swholmstead/Excavator/pictures/Excavator.jpeg

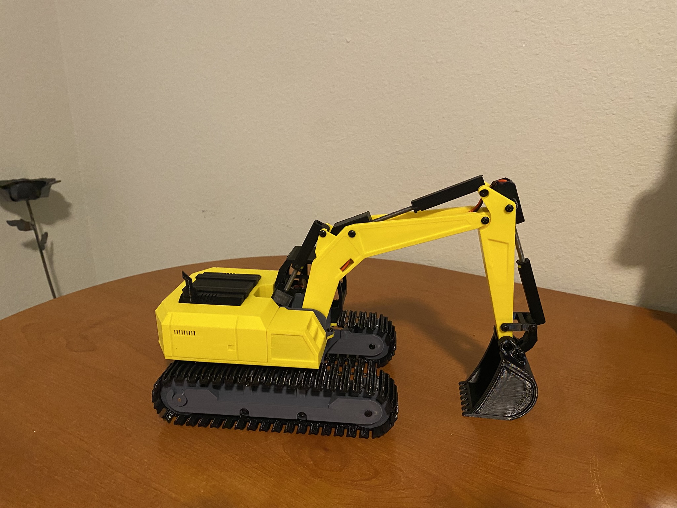
pictures/Excavator.jpeg
