swholmstead/Excavator/docs/bom.md

<h2>Bill of Materials</h2>

All of these components are common and can be found online. I have provided links to Amazon and AliExpress, but these vendors may change over time. If the links don't work, just search for the components from wherever you shop.

* ESP32 WROOM-32 Development Board [Amazon](https://www.amazon.com/dp/B08D5ZD528) [AliExpress](https://www.aliexpress.us/item/3256805767190776.html)
    * This is available with micro USB or USB-C.  Get the one that you like.
* N20 12V 100 RPM motors (qty 4) [Amazon](https://www.amazon.com/gp/product/B0B8DB6NC8) [AliExpress](https://www.aliexpress.us/item/3256806632632389.html)
* N20 12V 1000 RPM 55 mm motors (qty 3) [Amazon](https://www.amazon.com/dp/B0DGSZRN4X) [AliExpress](https://www.aliexpress.us/item/3256808399549453.html)
* M4 hex nut (qty 3) [Amazon](https://www.amazon.com/dp/B0CMC61C9D) [AliExpress](https://www.aliexpress.us/item/3256807407546447.html)
* 12.5 mm Micro Slip Ring 4 channel (qty 1) [Amazon](https://www.amazon.com/dp/B0D9L8DL1L) [AliExpress](https://www.aliexpress.us/item/3256805848469478.html)
    * You can always buy a slip ring with more channels and just cut off the extra wires.
* 5V Buck Converter [Amazon](https://www.amazon.com/dp/B0DGPZ91BD) [AliExpress](https://www.aliexpress.us/item/3256807692095306.html)
* DRV8833 H-bridge (qty 4) [Amazon](https://www.amazon.com/dp/B0DB8CX8LK) [AliExpress](https://www.aliexpress.us/item/3256806096142480.html)
* JST-XH connectors with 20 cm of wire (qty 8) [Amazon](https://www.amazon.com/dp/B0FHQ4F2Z2) [AliExpress](https://www.aliexpress.us/item/2251832479273592.html)
* SS12D10 SPDT micro slide switch [Amazon](https://www.amazon.com/gp/product/B09R41P1JF) [AliExpress](https://www.aliexpress.us/item/2255800493933955.html)
* PCB Headers 2.54 mm pitch [Amazon](https://www.amazon.com/2-54MM-Breakaway-Connector-Arduino-Prototype/dp/B08DVGCTKT) [AliExpress](https://www.aliexpress.us/item/2255800687544049.html)
* BLX-A Fuse holder 5 mm x 20 mm  (qty 1) [Amazon](https://www.amazon.com/dp/B093FK3GB1) [AliExpress](https://www.aliexpress.us/item/3256808172588255.html)
* 5A Fast-blow fuse 5 mm x 20 mm  (qty 1) [Amazon](https://www.amazon.com/dp/B07V5MYBL1) [AliExpress](https://www.aliexpress.us/item/3256803802728124.html)
* CR123a battery holder (qty 2) [Amazon](https://www.amazon.com/gp/product/B08RD1KQN3) [AliExpress](https://www.aliexpress.us/item/3256806203437629.html)
* CR123a rechargeable batteries (qty 2)
    * You can buy the batteries plus a charger [Amazon](https://www.amazon.com/dp/B0CF1SXDZ1)
    * Or get the ones with a built in charger [Amazon](https://www.amazon.com/dp/B0D3H7PBK8)
* 3 mm 12V LED lights [Amazon](https://www.amazon.com/dp/B07T9KX9BP) [AliExpress](https://www.aliexpress.us/item/3256803264288460.html)
* 3 mm LED holder [Amazon](https://www.amazon.com/dp/B07NRWLWCP) [AliExpress](https://www.aliexpress.us/item/3256803821521152.html)
* M2.6 x 6 mm self-tapping pan head screws [Amazon](https://www.amazon.com/dp/B08QF455PJ) [AliExpress](https://www.aliexpress.us/item/3256806345826640.html)
* M2.6 x 8 mm self-tapping pan head screws [Amazon](https://www.amazon.com/dp/B08QF455PJ) [AliExpress](https://www.aliexpress.us/item/3256806345826640.html)

<h3>Claw Parts</h3>
You only need these parts if using the claw option.  Not required for bucket.

* 6 mm or 6.5 mm Micro Slip Ring 4 channel (qty 1) [Amazon](https://www.amazon.com/dp/B07YKYDFCH) [AliExpress](https://www.aliexpress.us/item/3256807273542039.html)
    * Print part 34 and 38 for the correct size of slip ring that you buy.
    * You can always buy a slip ring with more channels and just cut off the extra wires.
* 21g Mini Metal Servo (qty 1) - these are more powerful than standard 9g servos [Amazon](https://www.amazon.com/dp/B0D5QJVRC1) [AliExpress](https://www.aliexpress.us/item/3256804867324754.html)

<h3>Optional</h3>

* JST-XH Crimp Connectors [Amazon](https://www.amazon.com/dp/B0B2R966ZY) [AliExpress](https://www.aliexpress.us/item/3256806894018733.html)
* Clear Heat Shrink Tubing [Amazon](https://www.amazon.com/dp/B01M6YB9CB) [AliExpress](https://www.aliexpress.us/item/3256805092198563.html)
    * I like to label my wires with a label maker and cover it with clear heat shrink tubing.
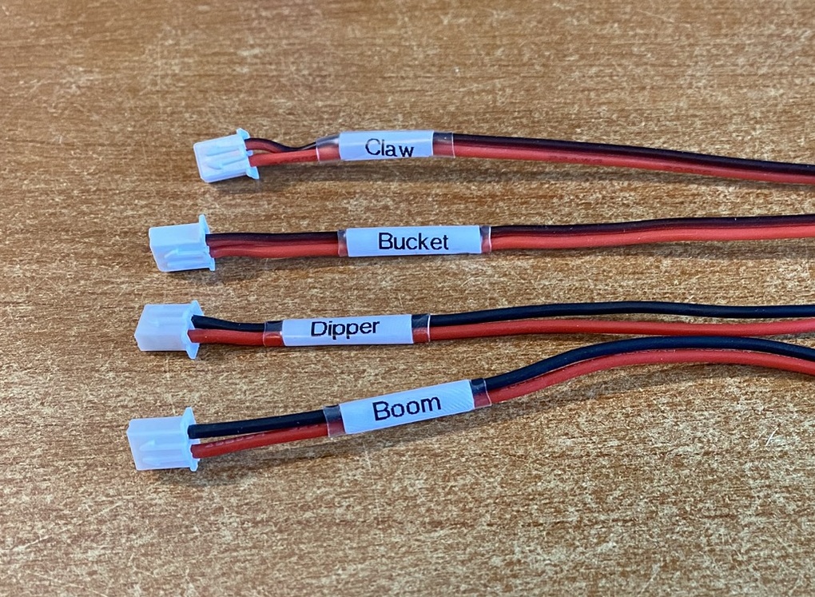
[picture p12: pictures/Heat_Shrink.jpg]
Wire Labels
