swholmstead/Excavator/docs/assembly.md

<h2>Assembly Instructions</h2>

<h3>Lower Body</h3>

Push N20 100 rpm motors into Wheel Motors.

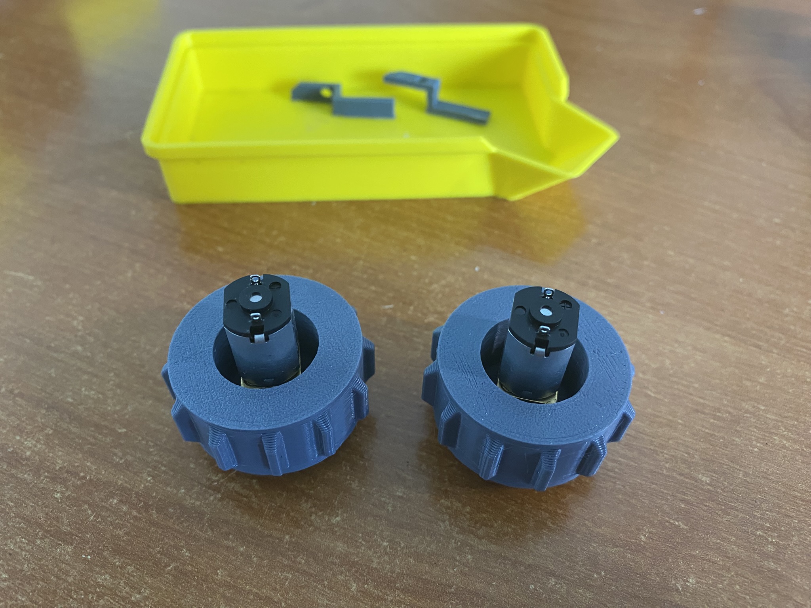
[picture p13: pictures/IMG_3700.JPEG]
Wheel Motor


Insert Wheel Motor assembly into Track Support Left. Secure with Motor Lock Left and a M2.6 x 6 mm screw.  I like to make sure
positive (+) terminal on the motor is on top.  It makes it easier for soldering later.

Insert Wheel Idler on other end of Track Support Left and secure with M2.6 x 8 mm screws.  Make sure screws are loose enough
for idler wheel to rotate freely.

Insert 2 Track Roller Uppers and 2 Track Roller Lowers onto Track Support Left and secure with M2.6 x 6 mm screws.  Make sure
that all rollers can rotate freely.

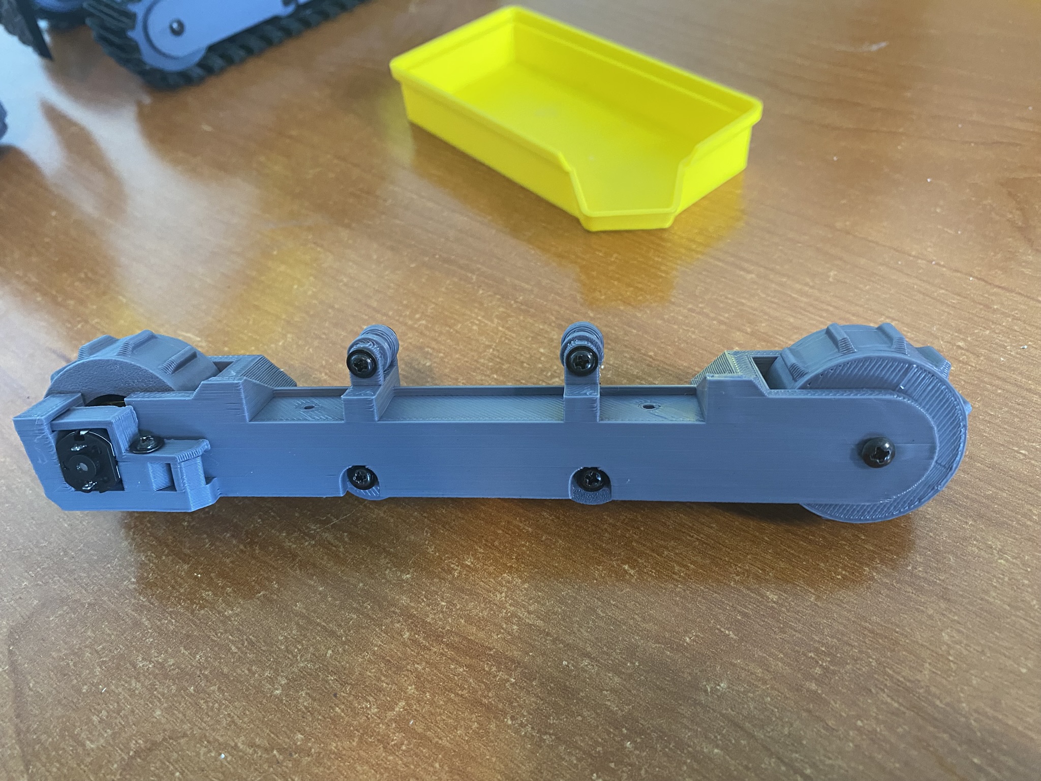
[picture p14: pictures/IMG_3701.JPEG]


Repeat same steps for Track Support Right.

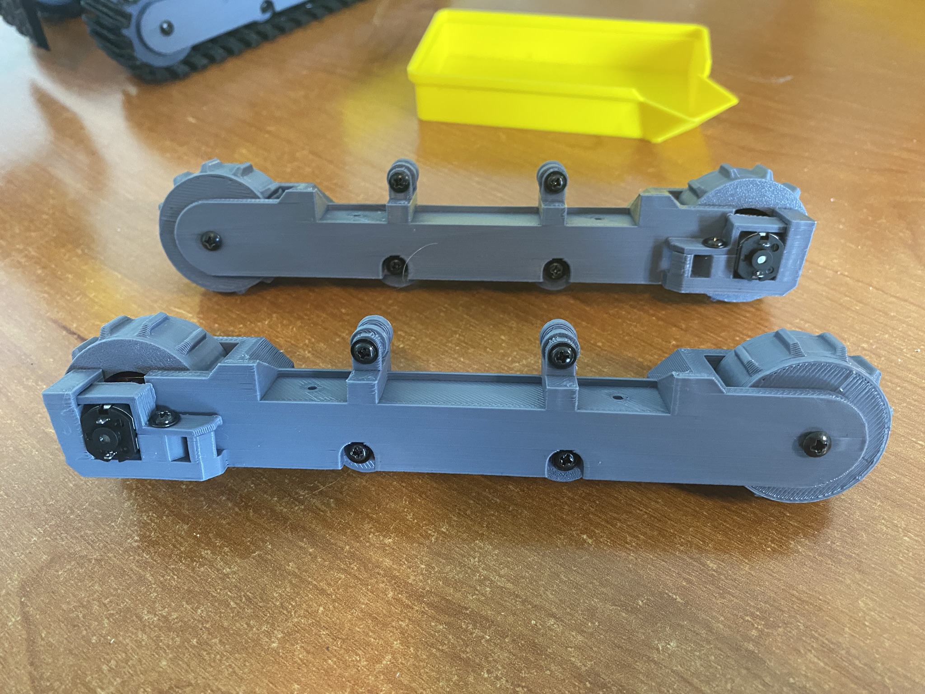
[picture p15: pictures/IMG_3703.JPEG]


Attach Lower Frame between left and right track supports and secure with M2.6 x 8 mm screws.  Ensure that the wire channel faces towards
the rear with the N20 100 rpm motors.

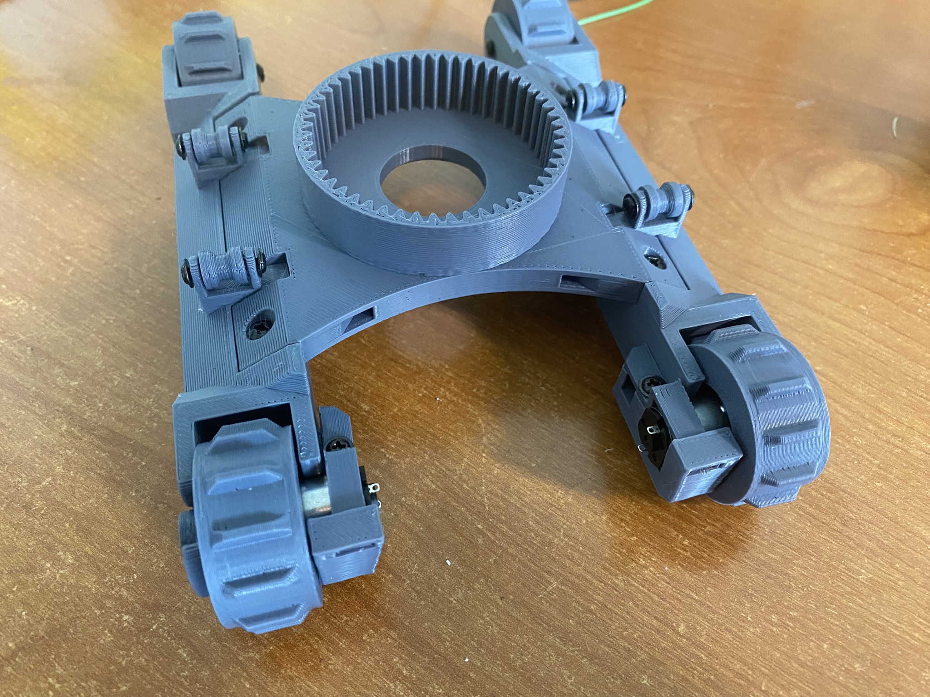
[picture p16: pictures/IMG_3704.JPEG]
Lower Frame


Insert the 12.5 mm slip ring into the Slip Ring Lock.  

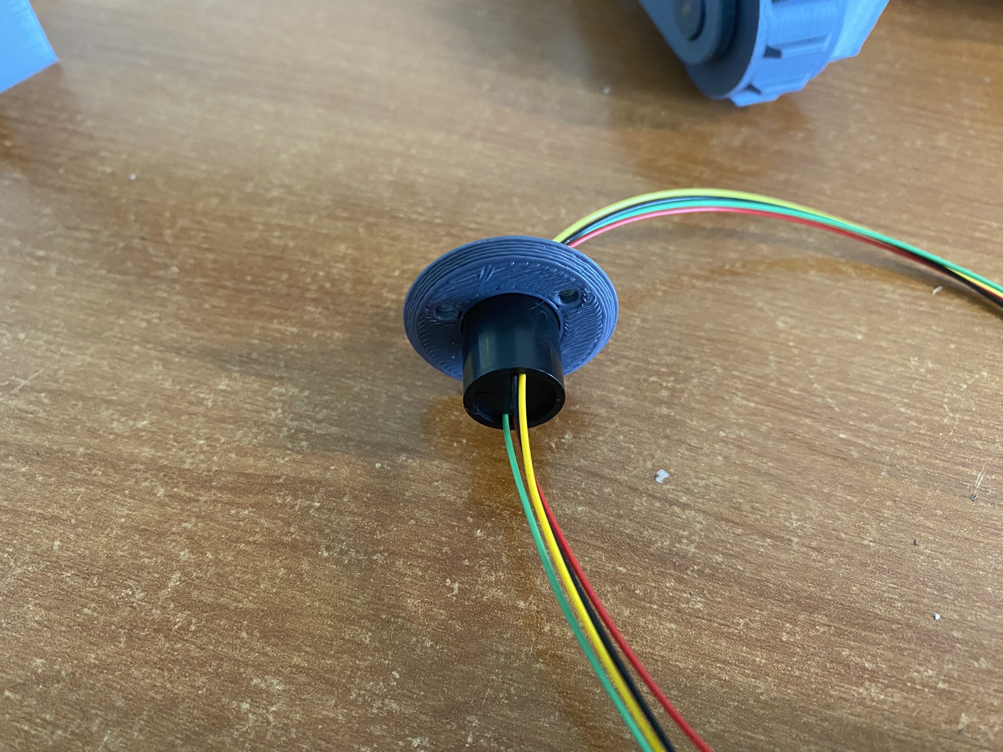
[picture p17: pictures/IMG_3705.JPEG]


Assemble the Track Support and Lower Body.  Push the wires of the slip ring through from the bottom and secure the
slip ring with M2.6 x 8 mm screws. Make sure the lower cab can freely rotate from the track support assembly.

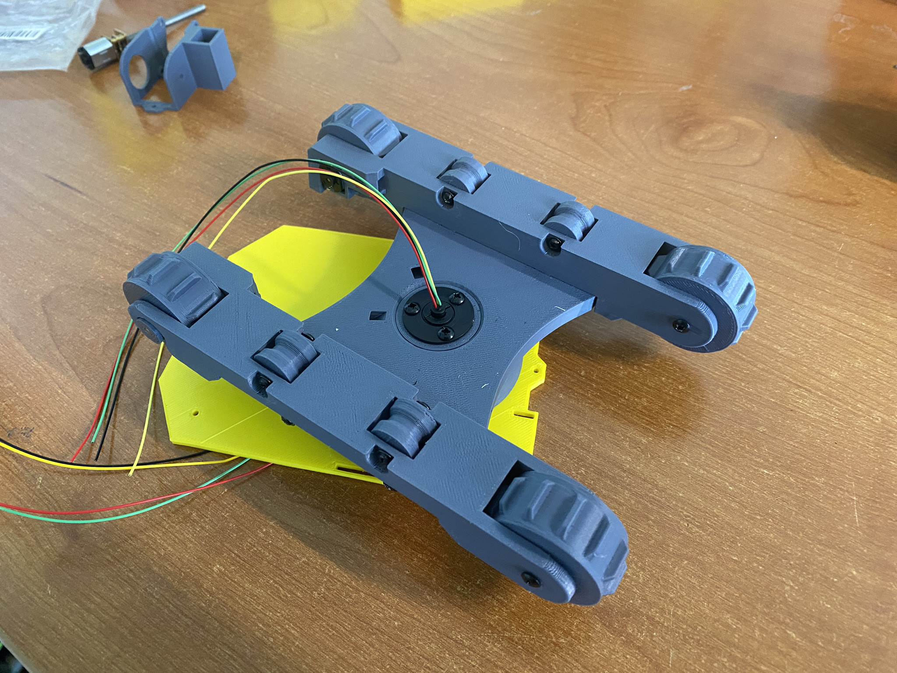
[picture p18: pictures/IMG_3706.JPEG]

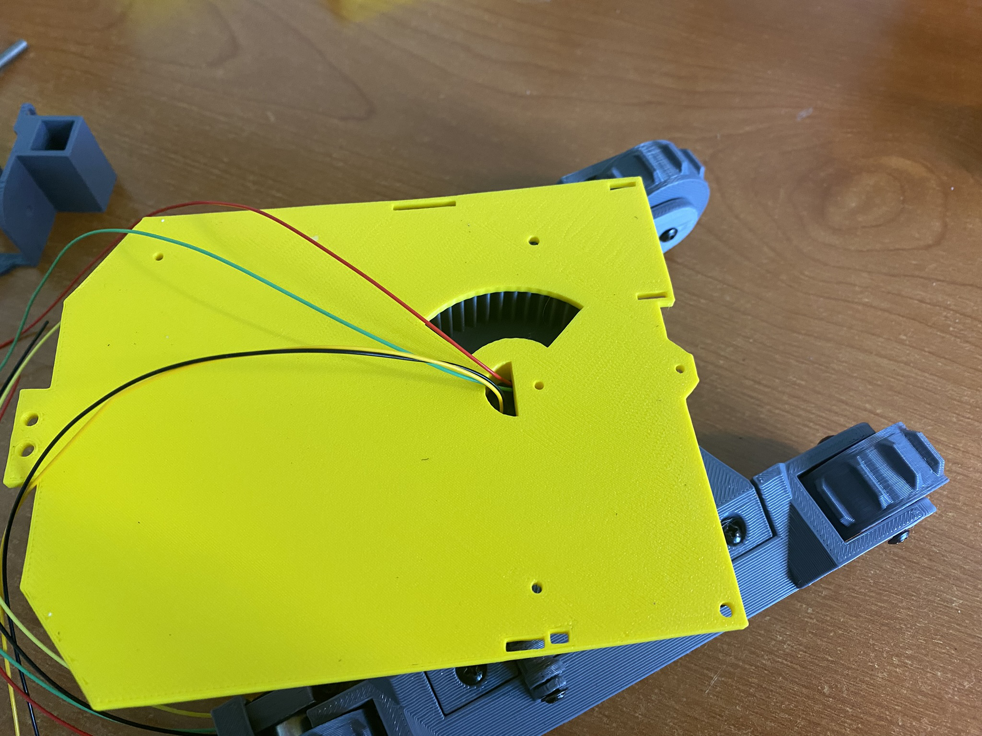
[picture p19: pictures/IMG_3707.JPEG]


Route a pair of wires to each motor.  Cut to length and solder wires to motors.

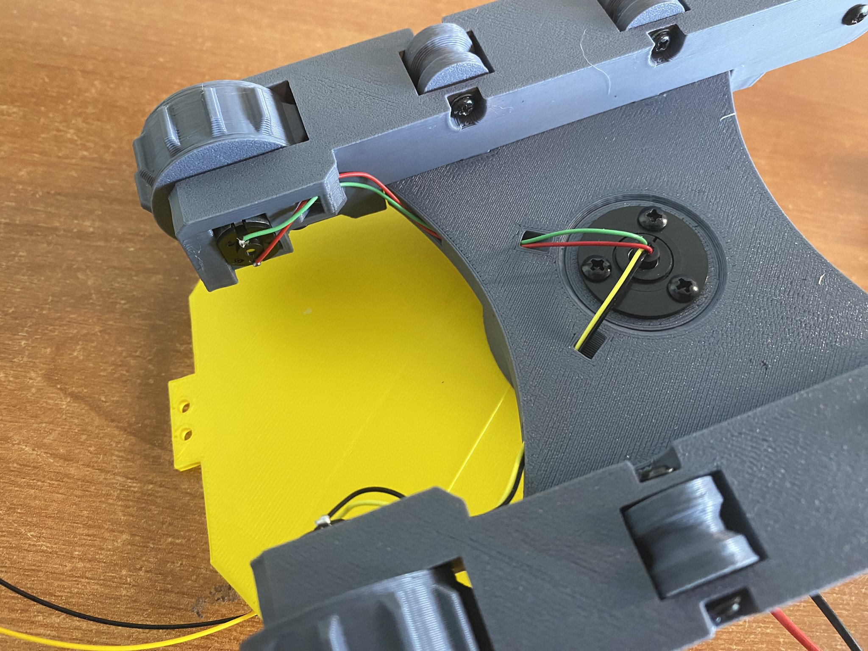
[picture p20: pictures/IMG_3712.JPEG]


Push N20 100 rpm motor into Main Boom Holder and press Pinion Gear on other side.

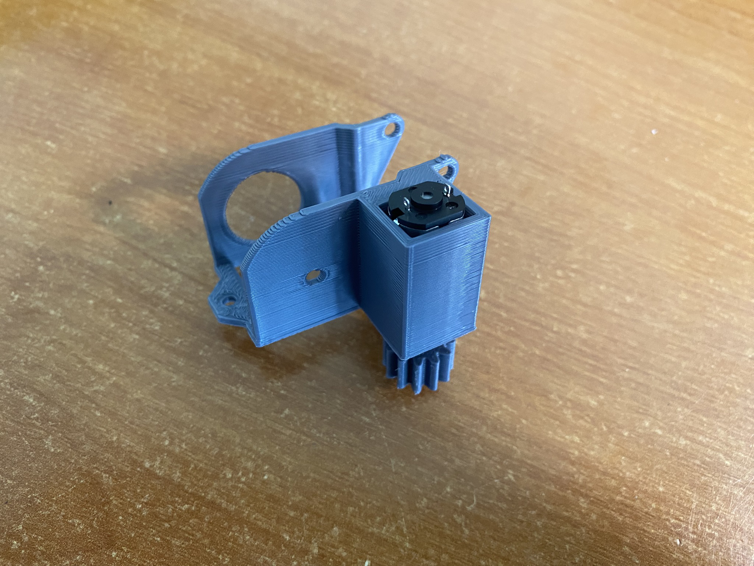
[picture p21: pictures/IMG_3709.JPEG]


Attach Main Boom Holder to base with M2.6 x 8 mm screws.  Attach JST-XH connector to 8 cm of wire and solder to
swing motor.

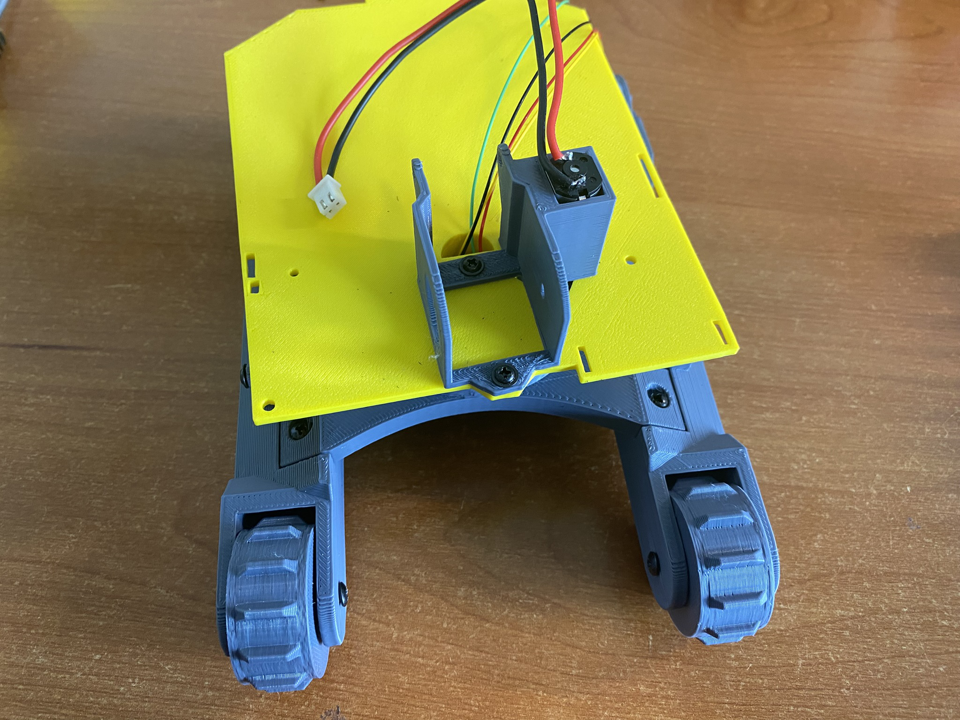
[picture p22: pictures/IMG_3713.JPEG]


Attach circuit board to lower body with M2.6 x 6 mm screws.  Add JST-XH connectors for left/right track motors
from swivel ring and attach to circuit board.  Attach swivel motor to circuit board. 

Attach seat to lower body with M2.6 x 6 mm screw.

Install TPU tracks.

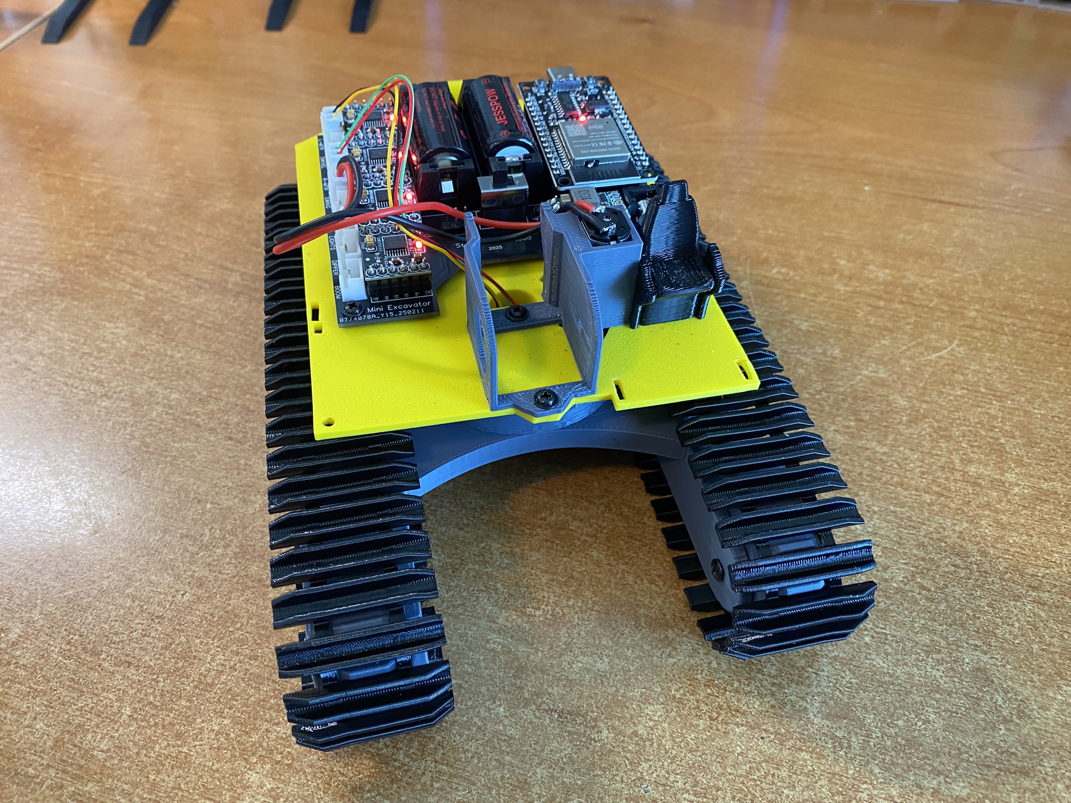
[picture p23: pictures/IMG_3728.JPEG]
Lower Body


You should be able to power on, connect XBox/PS controller, and verify operation of tracks and swivel.
Remember, to operate tracks, you must be in drive mode.  To switch out of drive mode, press in on the left joystick.
Then you will be able to operate swivel (and boom when finally connected).

<h3>Boom and Dipper Arms</h3>

Attach boom to dipper with M2.6 x 6 mm screws.

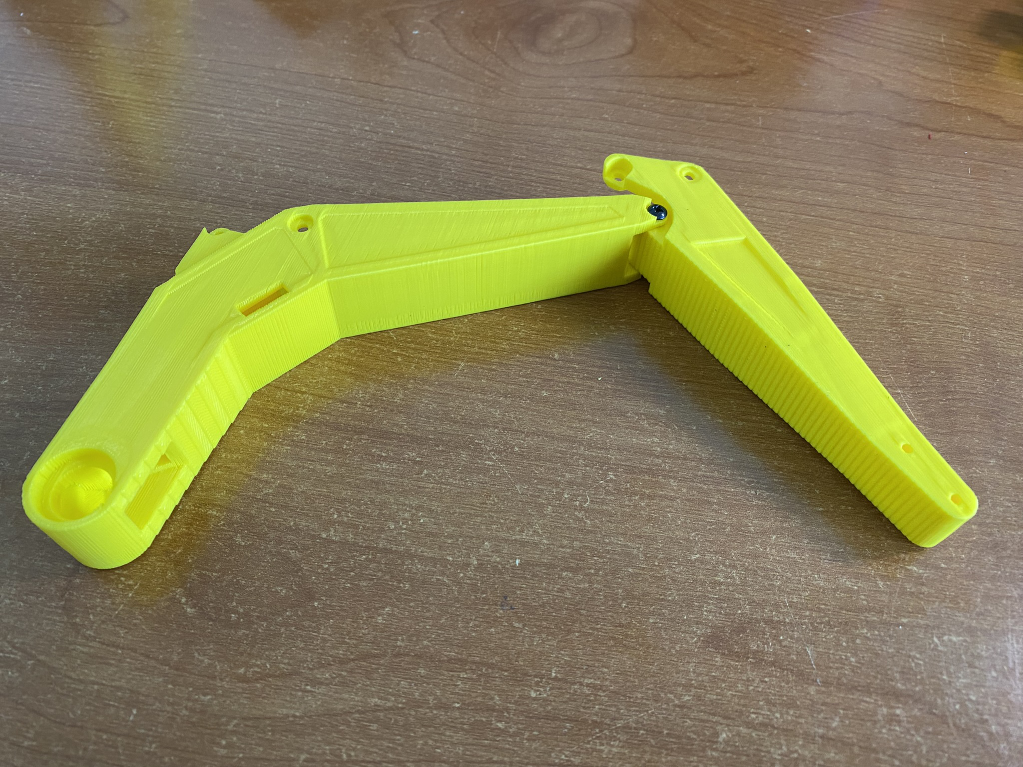
[picture p24: pictures/IMG_3731.JPEG]
Boom Arm


Attach JST-XH connectors to the following length of wires:

* Boom - 10 cm
* Dipper - 10 cm
* Bucket - 15 cm
* Claw - 20 cm (<b>Optional</b> - only if doing the Claw option)

I like to label my wires.  I use a label maker and then cover it with transparent Heat Shrink Tubing.

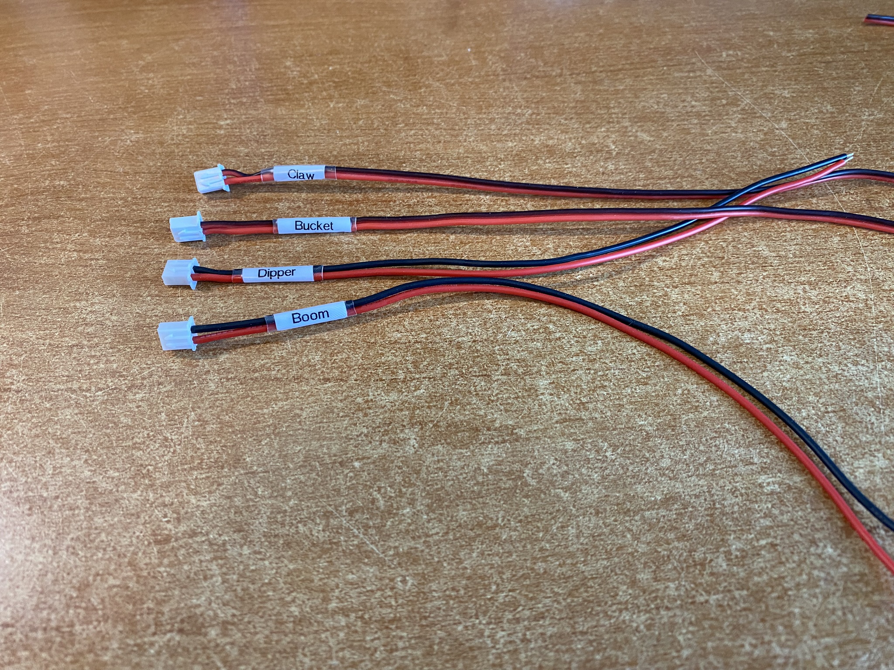
[picture p25: pictures/IMG_3729.JPEG]
Motor Wires


Route the Dipper, Bucket, and Claw (optional) wires into the boom as dipper as shown.  The Boom wires do not need
to be routed through the Boom arm.

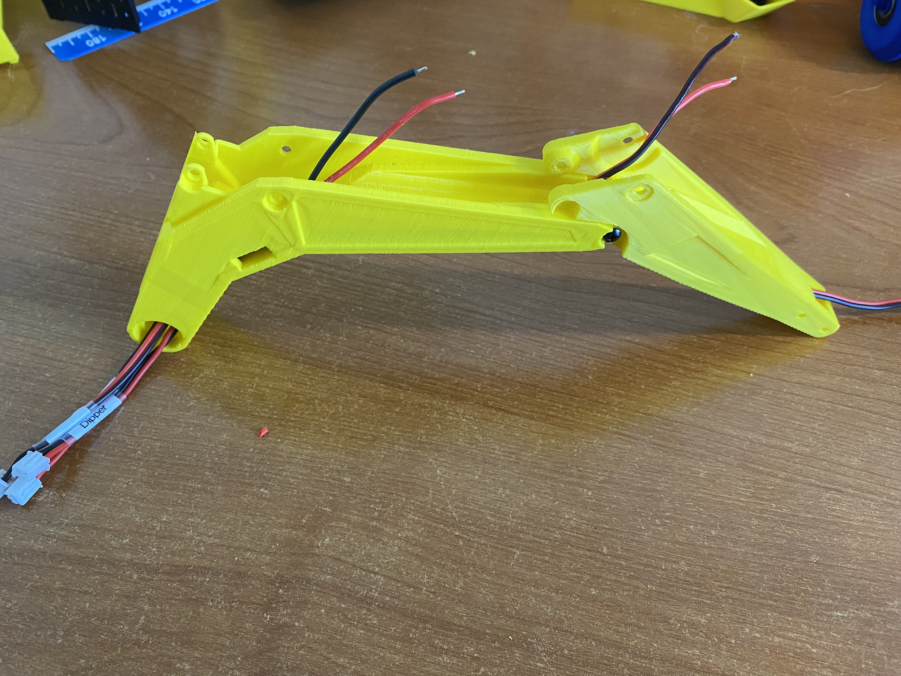
[picture p26: pictures/IMG_3732.JPEG]
Boom Wires


Press M4 hex nut into boom shaft and both dipper shafts.  Make sure that they are fully seated and the center of the nut
is in the center of shaft.

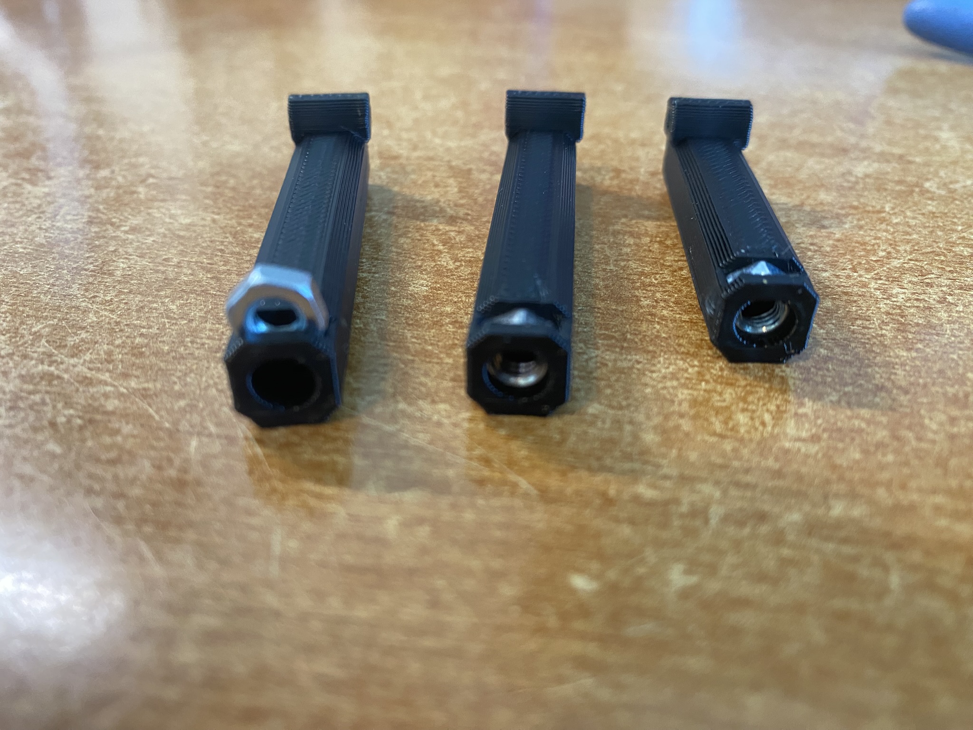
[picture p27: pictures/IMG_3714.JPEG]


Insert N20 100rpm motor into each Swivel Motor and secure with Swivel Motor Lock.  Hand screw together shafts and swivel.

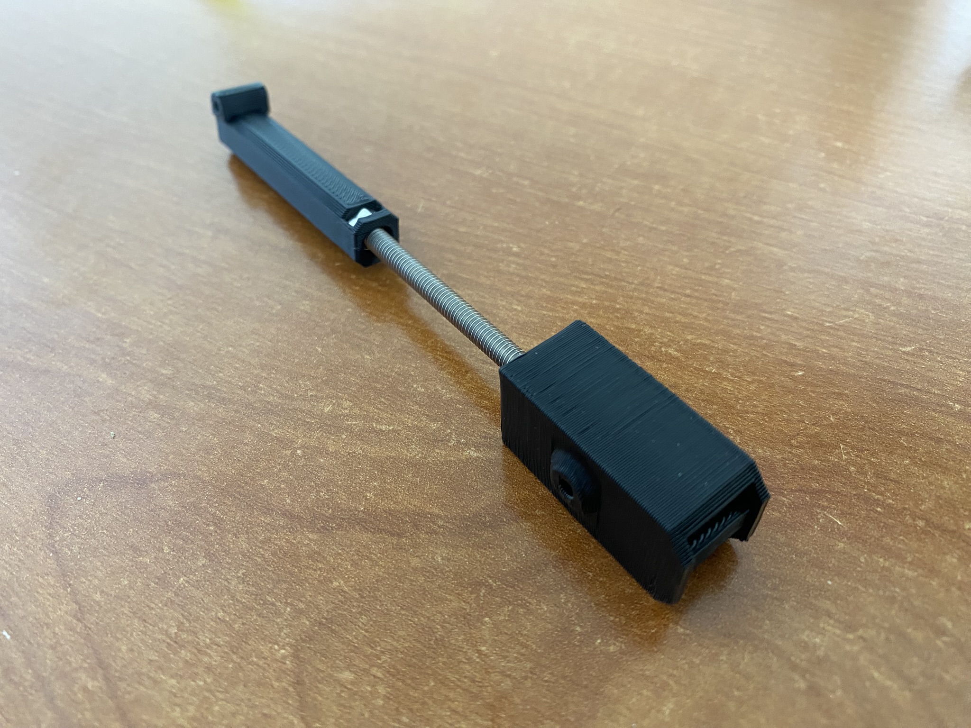
[picture p28: pictures/IMG_3749.JPEG]


Solder motor wires to motors. Leave bucket motor wire for now.

Attach Bucket Swing Arm and Bucket Push Link to dipper with M2.6 x 6 mm screws.

Attach dipper motor and bucket motor with M2.6 x 6 mm screws.  Ensure that screws are not too tight that they bind
the motor.  I like to cut off the tip of the screw to remove the point that can cause binding of the N20 motor.

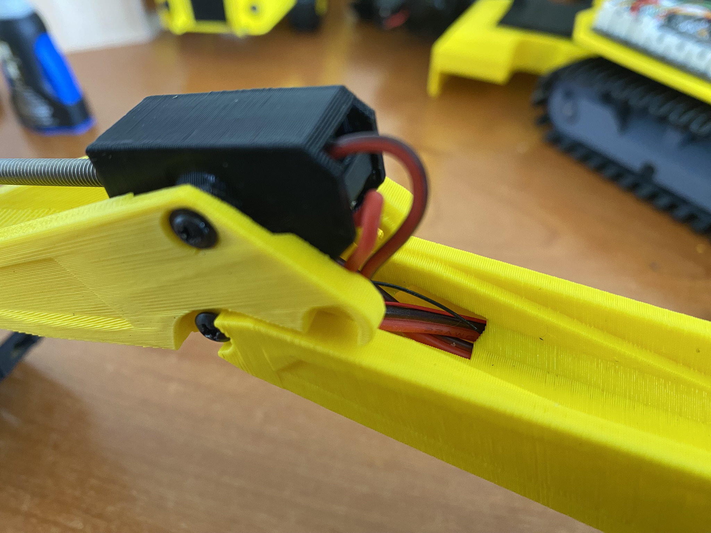
[picture p29: pictures/IMG_3750.JPEG]

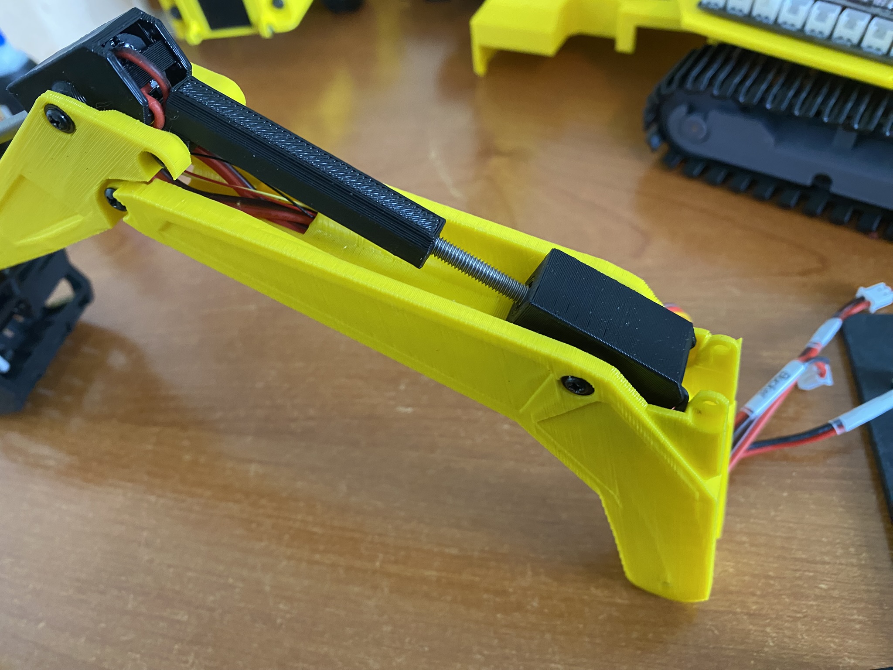
[picture p30: pictures/IMG_3752.JPEG]

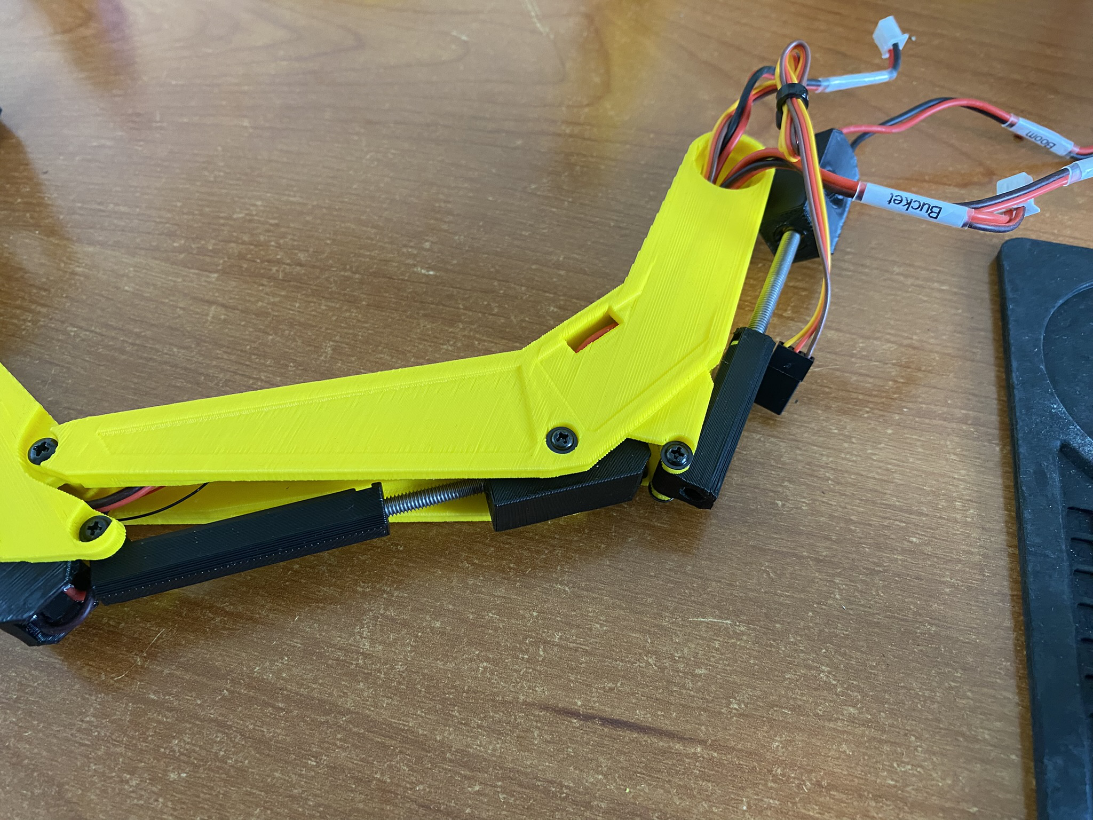
[picture p31: pictures/IMG_3753.JPEG]


Attach boom to cab base with Motor Swivel and M2.6 x 6 mm screw.  Attach boom motor to cab base and boom arm.

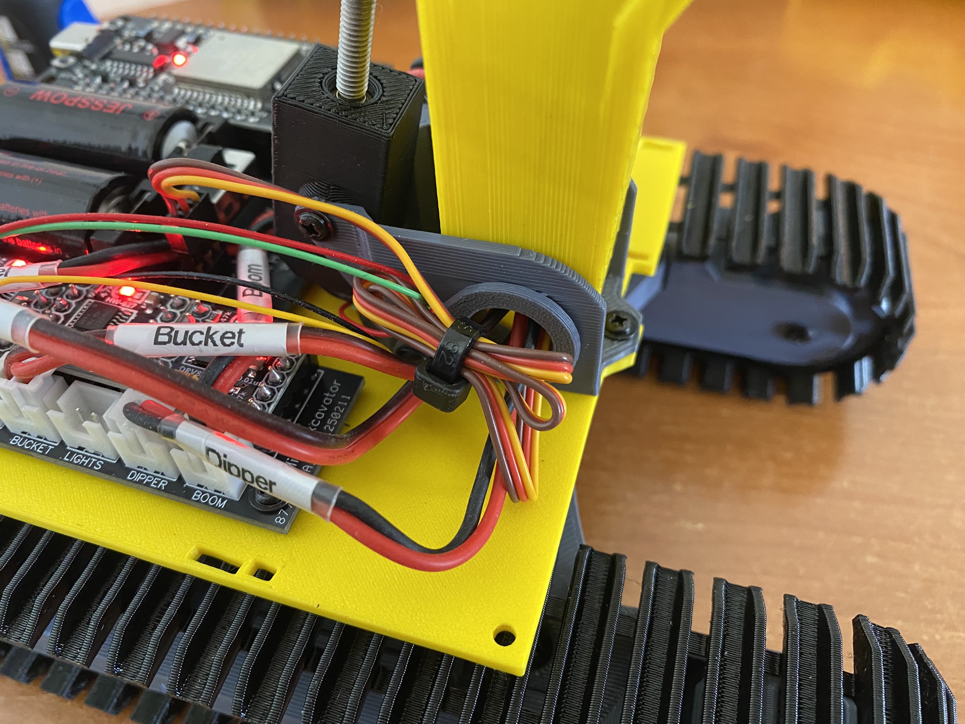
[picture p32: pictures/IMG_3754.JPEG]

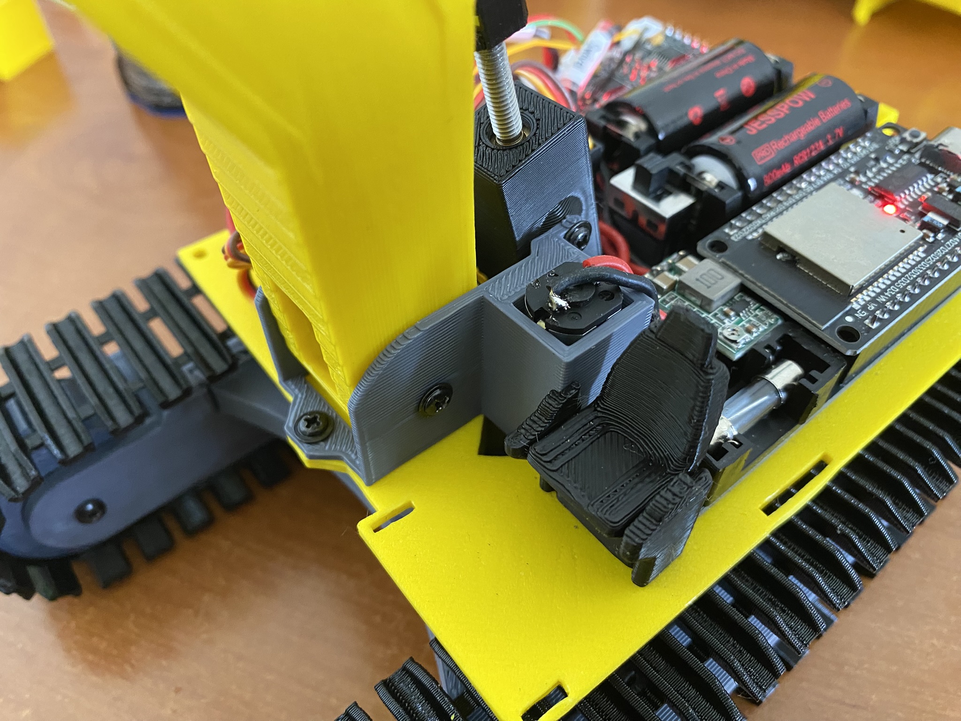
[picture p33: pictures/IMG_3755.JPEG]


<h3>Bucket (Option 1)</h3>

Attach Bucket to Bucket Swing Arm and Bucket Push Link with M2.6 x 6 mm and M2.6 x 8 mm screws.

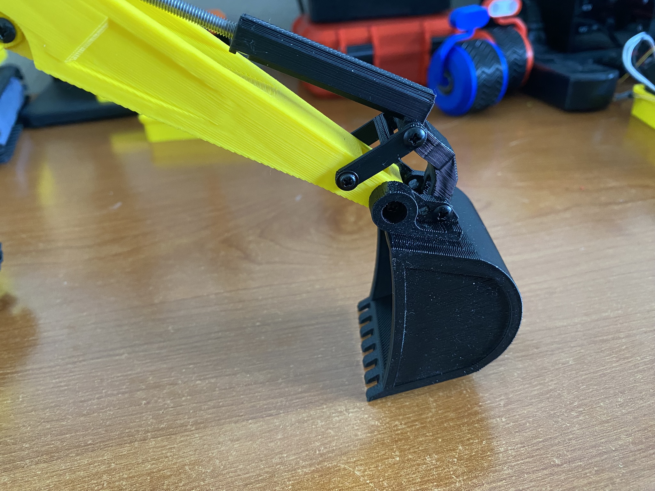
[picture p34: pictures/IMG_3734.JPEG]
Bucket


<h3>Claw (Option 2)</h3>

Insert Claw Gear into Gear Retention with small end of Claw Gear facing inwards.

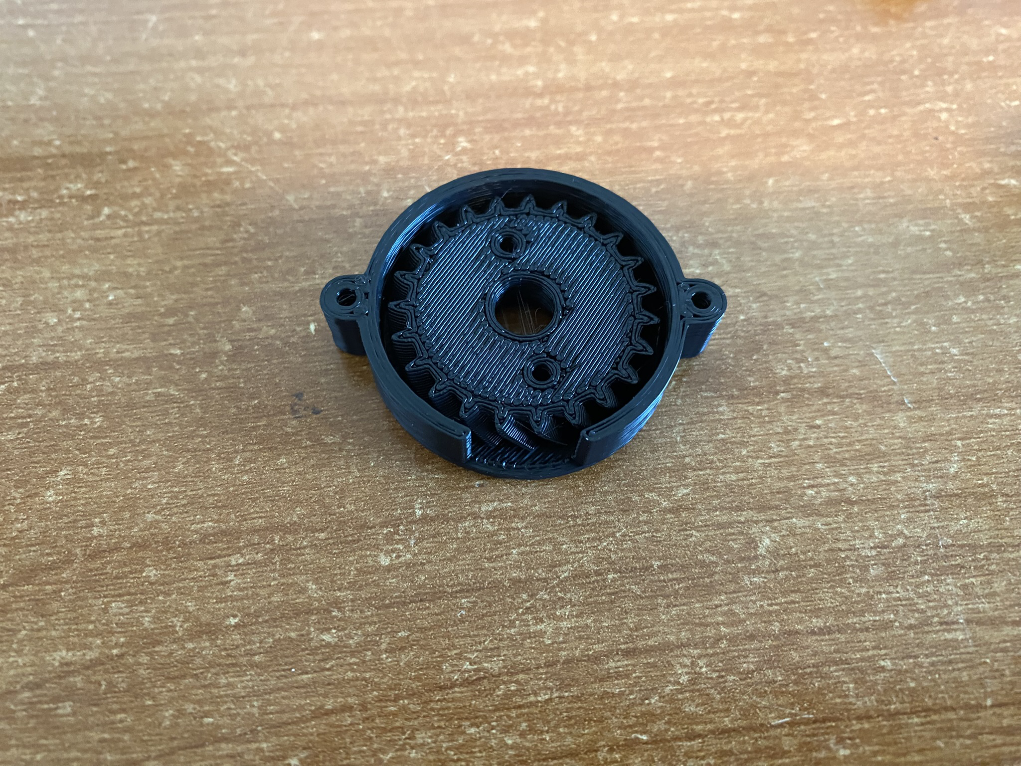
[picture p35: pictures/IMG_3720.JPEG]
Claw Gear


Turn over and attach Claw Servo Holder with M2.6 x 6 mm screws.  Ensure that gear retention ring can still rotate freely.

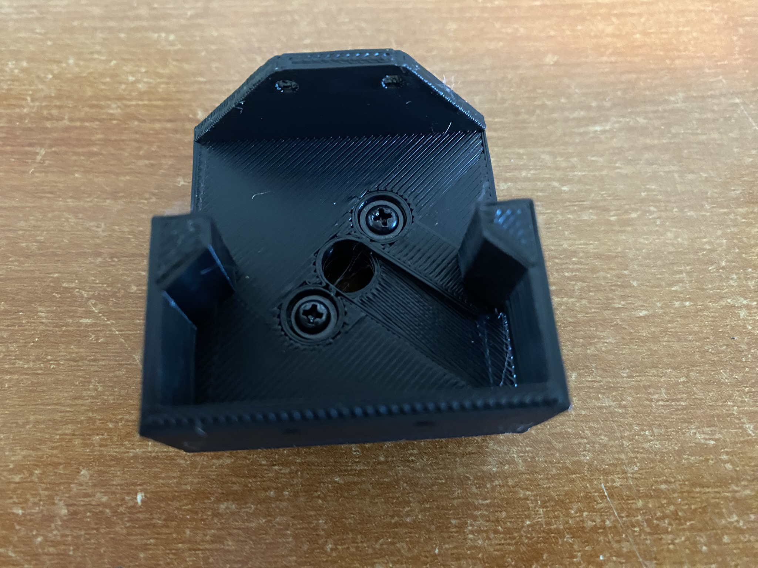
[picture p36: pictures/IMG_3721.JPEG]
Claw Base


Shorten wires on ONE SIDE of 6 mm or 6.5 mm slip ring to 5 cm long.  I like to shorten the side where the wires are on
the outside of the slip ring.  We only need 3 wires.  I like to use the Black, Red, and Yellow wires, since they
are the closest match to the wires on the 21g Servo.  Carefully clip off extra wires so they are not in the way.  

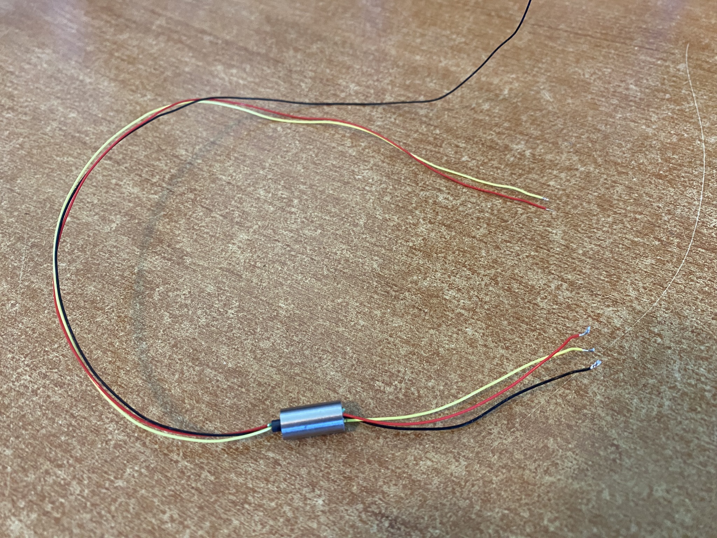
[picture p37: pictures/IMG_3736.JPEG]


Remove the 4 small screws on the bottom of the 21g servo.  Replace the 3 wires with wires from the shortened end
of the slip ring.  Make sure that the wires are in the same order from left to right: yellow, red, black.

Keep the removed wires and connector.  We will solder those onto the other end of the slip ring
wires later.

<b>NOTE: If you are uncomfortable with unsoldering the wires and replacing them on such a small circuit board,
then just cut the wires on the servo and solder the slip ring wires outside the servo case.  Make sure to cover
joints with heat shrink tubing.</b>

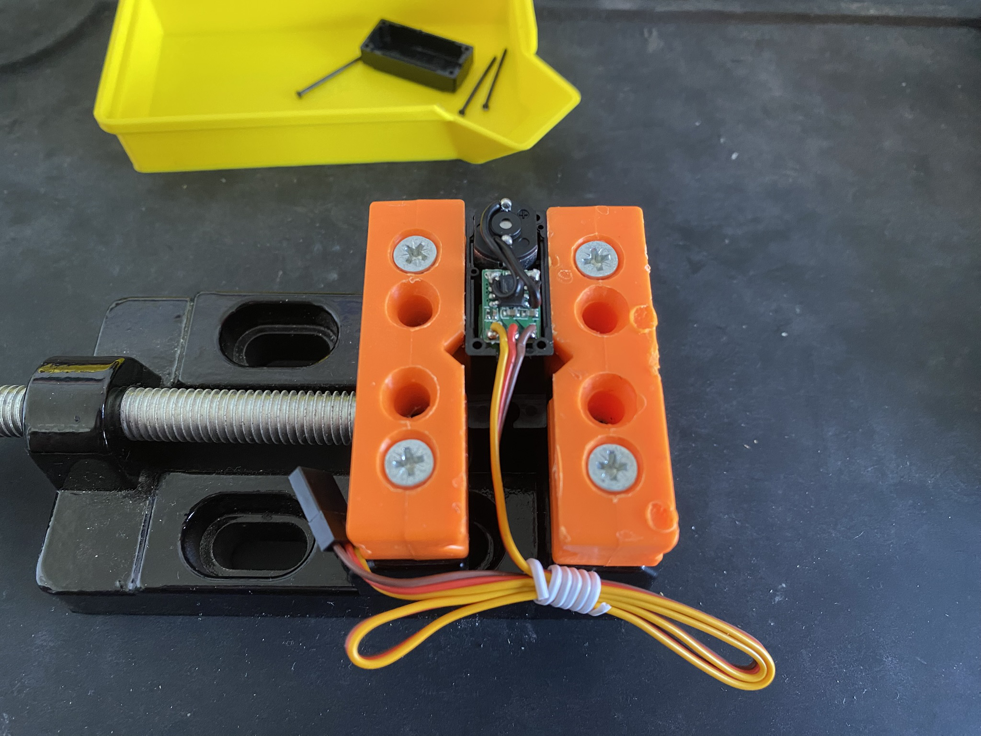
[picture p38: pictures/IMG_3738.JPEG]

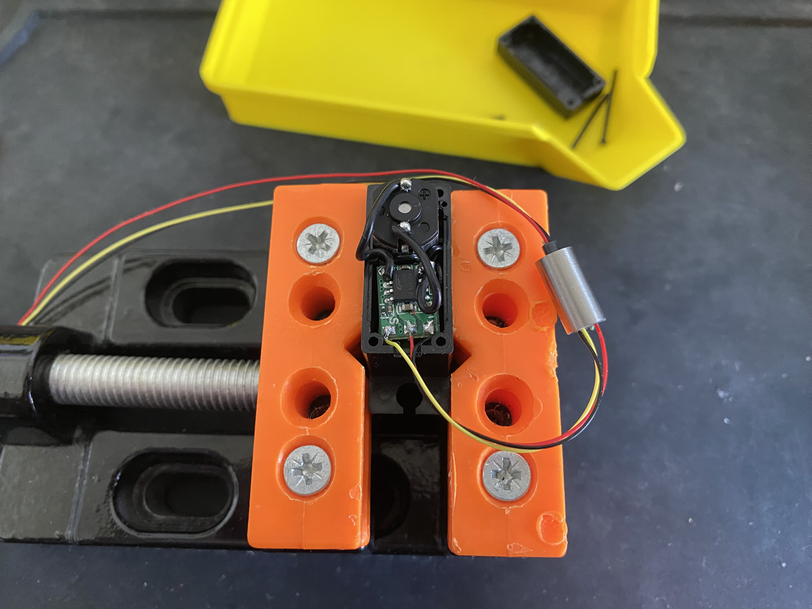
[picture p39: pictures/IMG_3739.JPEG]


Replace the cover and 4 screws on the 21g servo.  Attach the single blade and screw to the servo.  Try to get the blade to be vertical without moving servo.  Otherwise, you will need to come back and recalibrate claw after power is on.

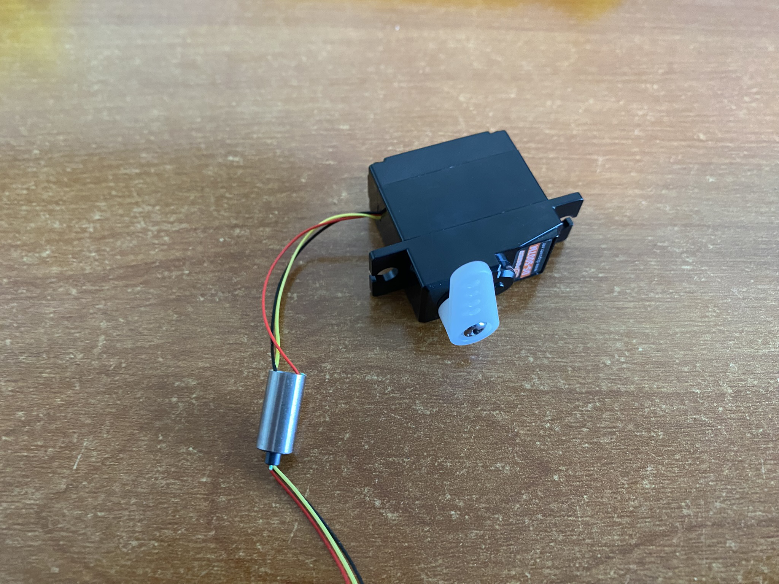
[picture p40: pictures/IMG_3741.JPEG]


Position the slip ring in the center hole and attach the 21g Servo to the Claw Servo Holder with M2.6 x 8 mm screws.

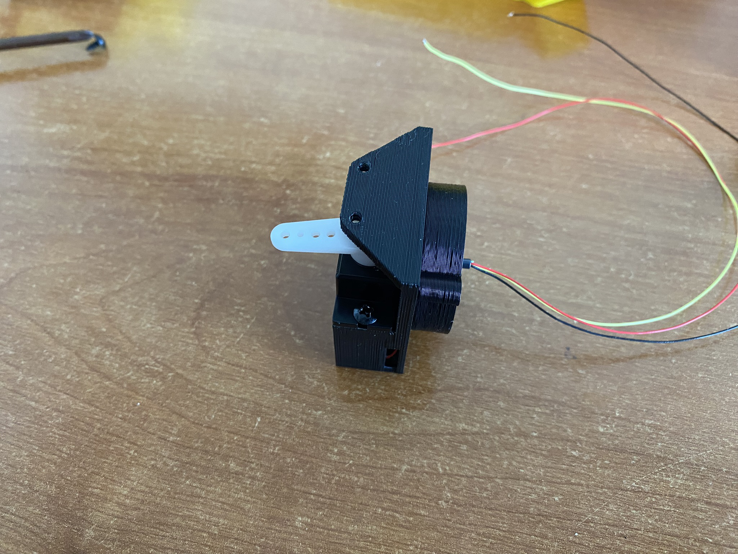
[picture p41: pictures/IMG_3742.JPEG]


Attach the Claw Push Link to the Claw Arm Left with M2.6 x 6 mm screw.  Attach both left and right Claw Arms to the
Claw assembly with M2.6 x 6 mm screws.

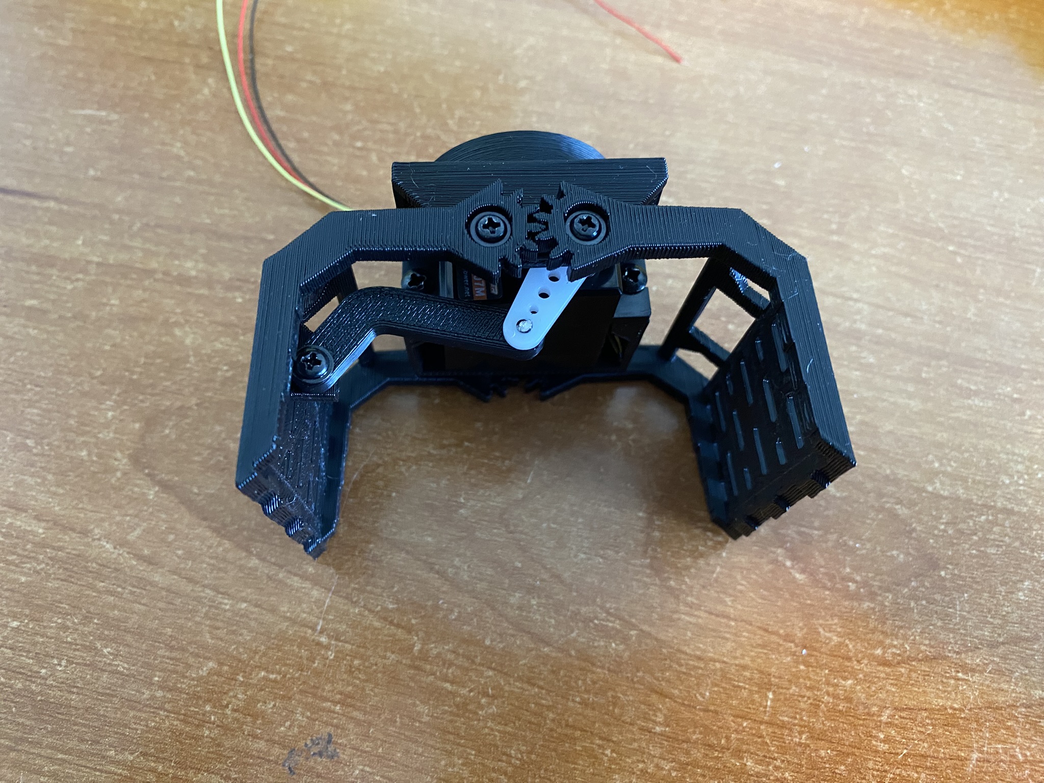
[picture p42: pictures/IMG_3743.JPEG]


Connect the Claw Attach to the Bucket Swing Arm and Bucket Push Link with M2.6 x 8 mm screws.

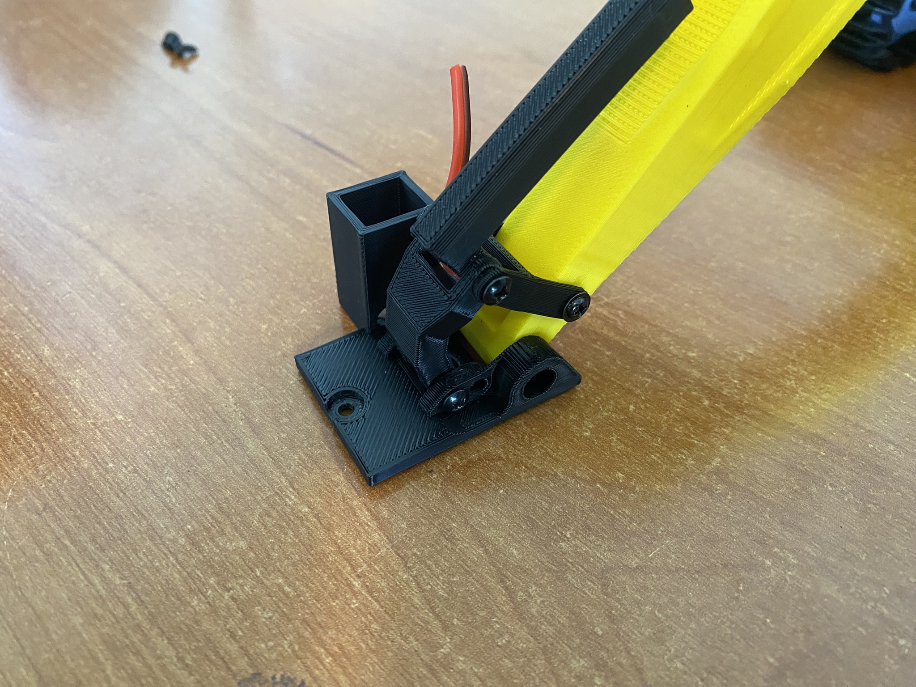
[picture p43: pictures/IMG_3744.JPEG]


Insert N20 100rpm motor into Claw Attach and press Claw Motor Gear onto N20 100 rpm motor.  Solder claw motor wires.

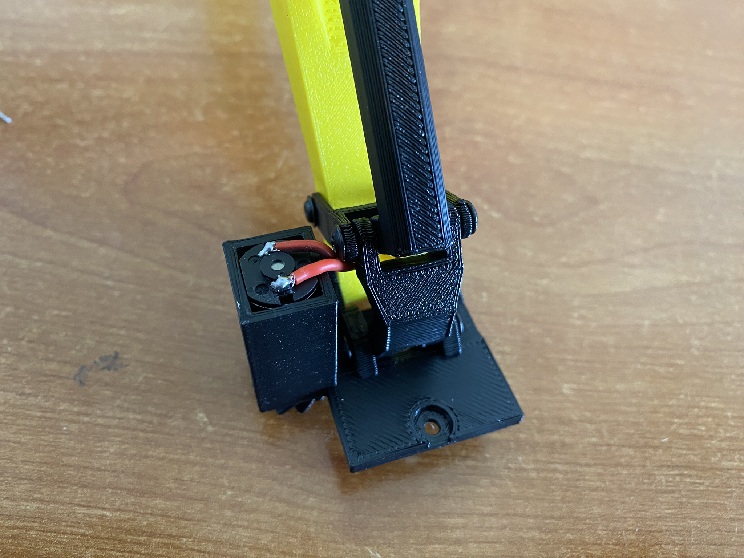
[picture p44: pictures/IMG_3746.JPEG]


Route the servo wires through the Boom and the slip ring wires through the Dipper.
Solder original 21g servo wires to slip ring wires and cover with heat shrink tubing.

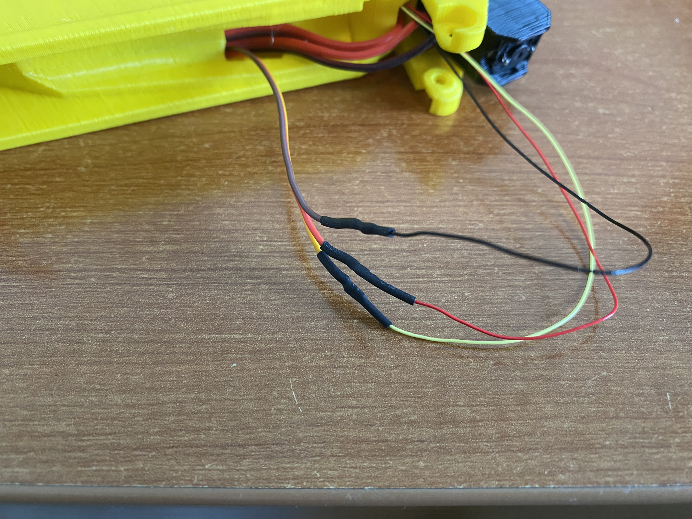
[picture p45: pictures/IMG_3748.JPEG]


Attach the claw assembly to the Claw Attach with M2.6 x 6 mm screws.  Pull on the 21g servo wires until the
wires are hidden within the Boom. Connect Claw servo to circuit board with yellow wire closest to the power switch.

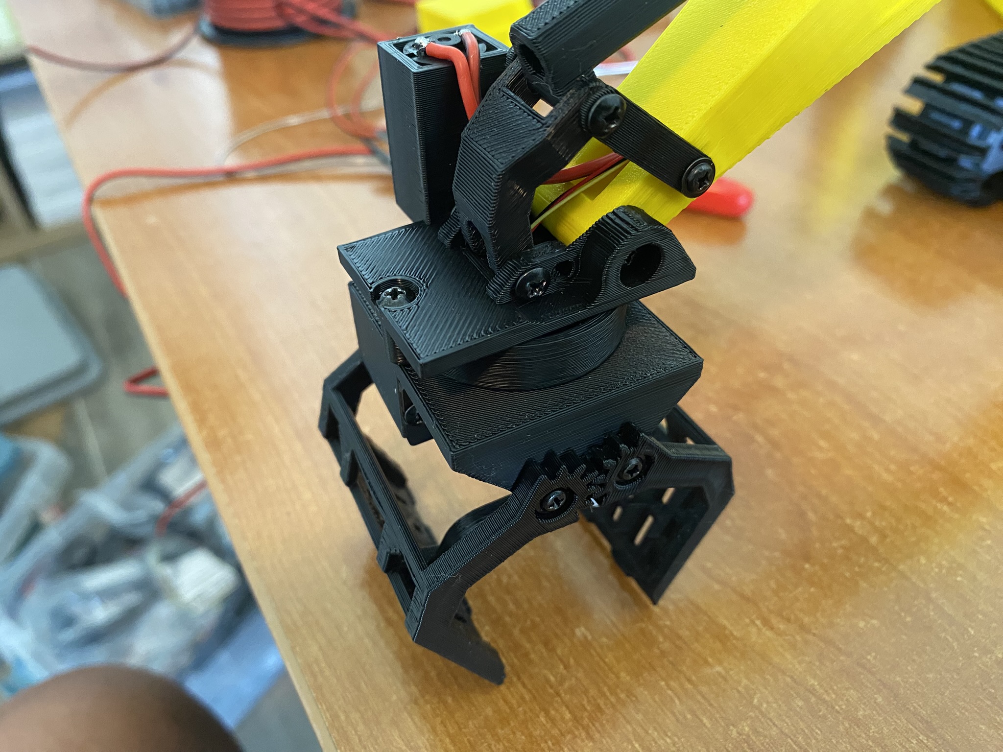
[picture p46: pictures/IMG_3747.JPEG]


<h3>Cab Main Body</h3>

Attach Step to lower body with M2.6 x 6 mm screw.  You may have to rotate the cab in order to get access to the
screw underneath the step.

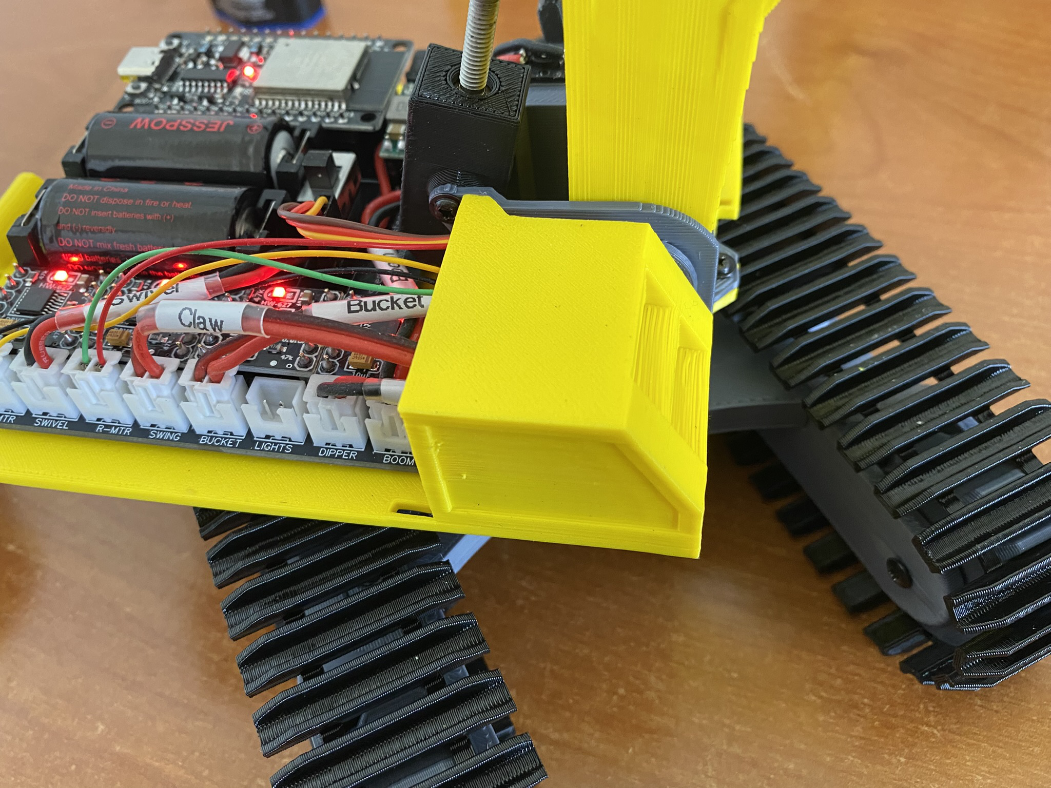
[picture p47: pictures/IMG_3757.JPEG]


Route LED with LED holder through Cab.  Connect both wires to a JST-XH connector.

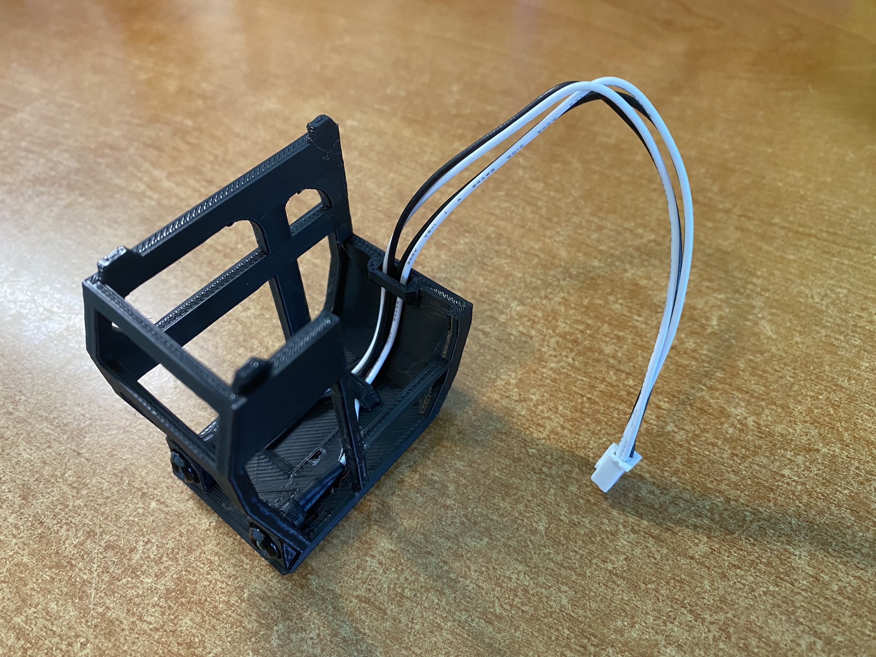
[picture p48: pictures/IMG_3717.JPEG]


Click Cab into lower body and plug lights into circuit board.

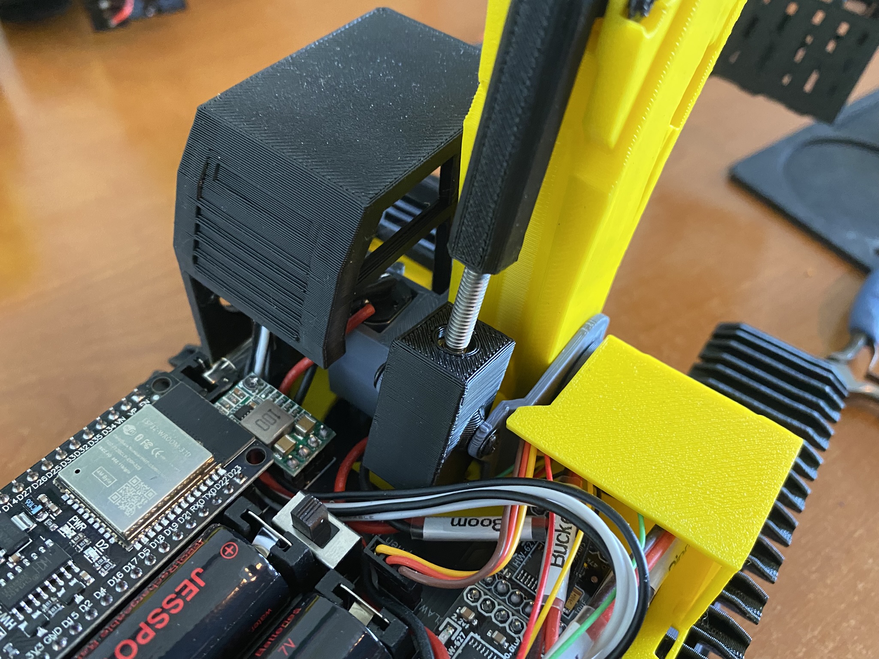
[picture p49: pictures/IMG_3758.JPEG]


Attach Swivel to lower body with M2.6 x 6 mm screws.  Attach Top Cover to Swivel with M2.6 x 8 mm screws.

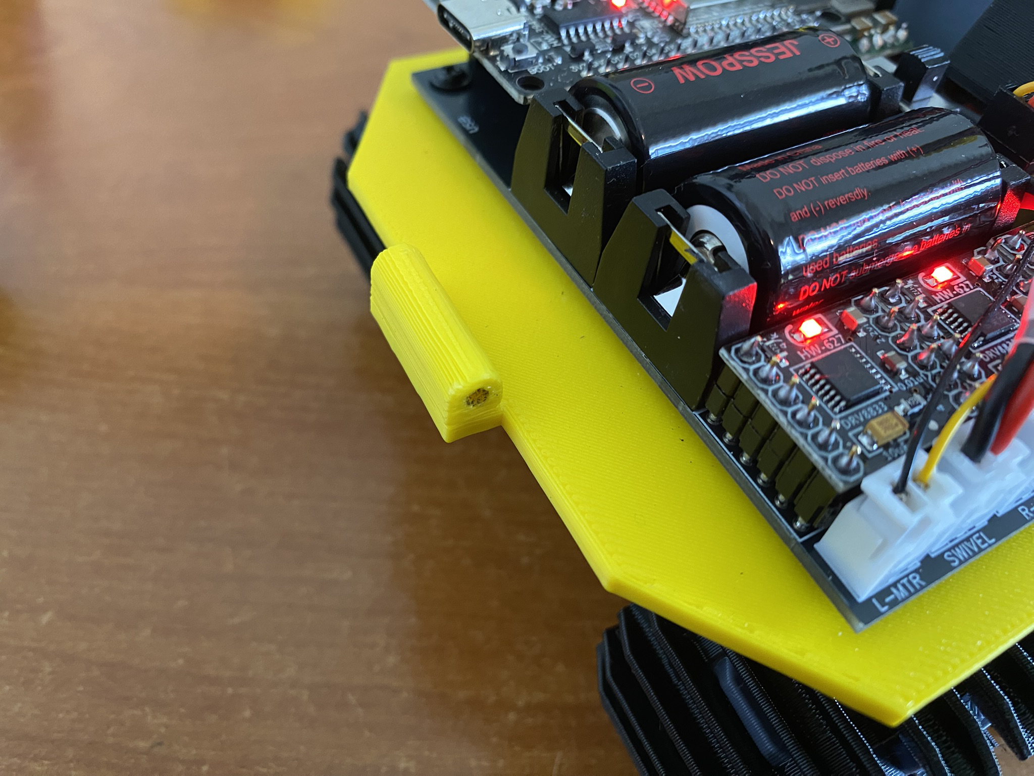
[picture p50: pictures/IMG_3756.JPEG]

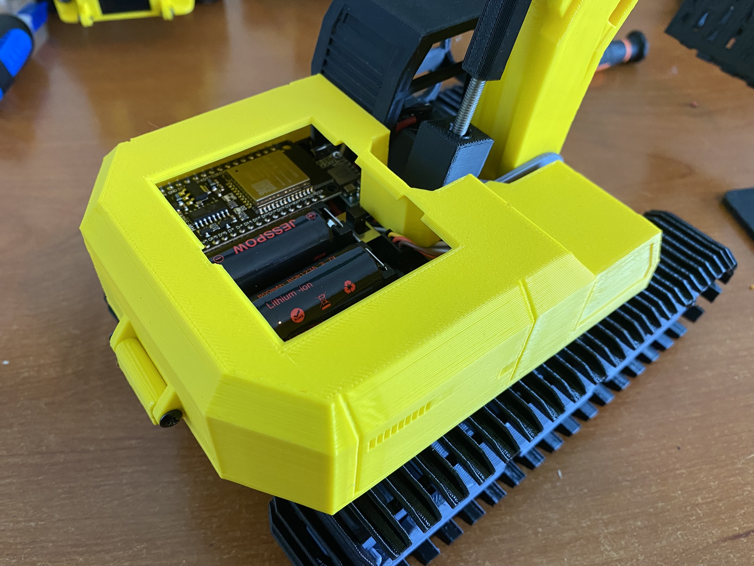
[picture p51: pictures/IMG_3759.JPEG]


Attach Exhaust Pipe to Engine Cover with M2.6 x 6 mm screw.  Click Engine Cover onto Top Cover.

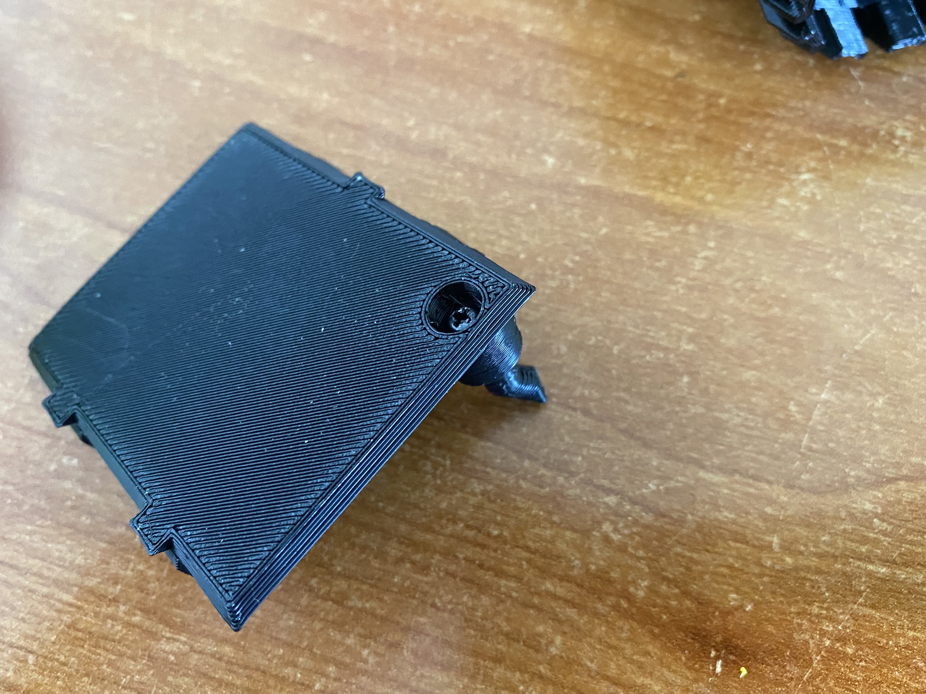
[picture p52: pictures/IMG_3760.JPEG]

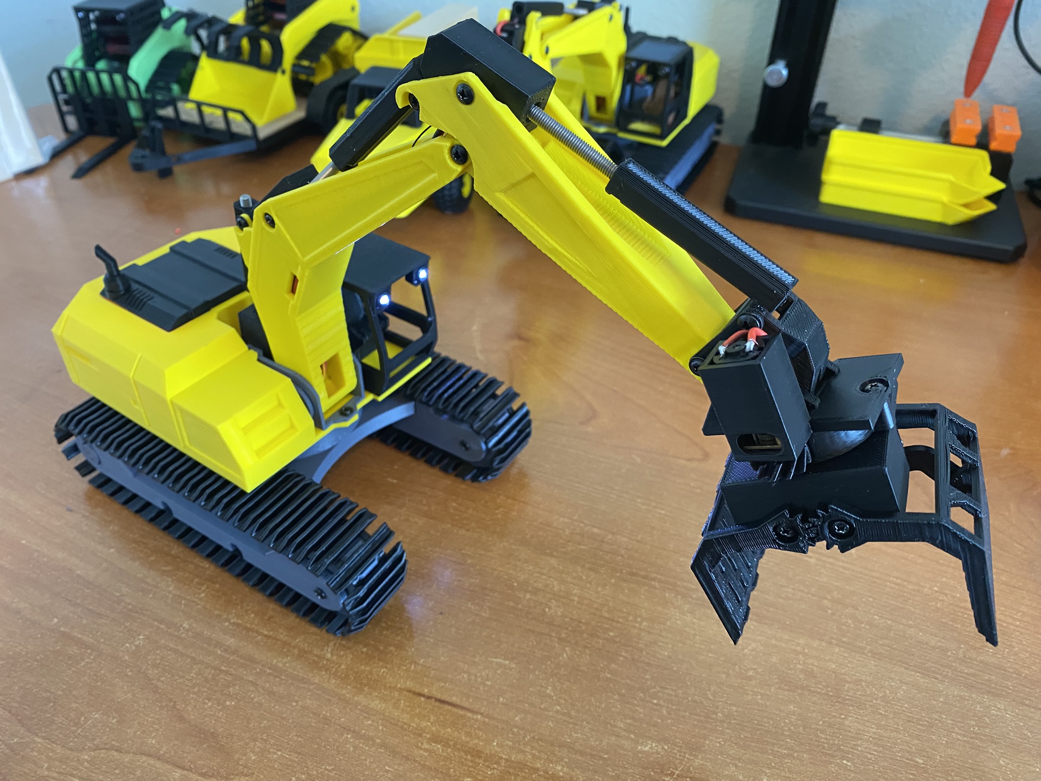
[picture p53: pictures/IMG_3761.JPEG]
