swholmstead/Excavator/(threads)

Thread 2 (2025-02-06):

Fix swing

swholmstead, 2025-02-06:
Modify swing motor to work on left X axis joystick as per control diagram.

Closed 2025-02-07.
