swholmstead/Excavator/Excavator_Bluepad.ino

#include <Arduino.h>
#include <ESP32Servo.h>  // by Kevin Harrington
#include <Bluepad32.h>   // by Ricardo Quesada

ControllerPtr myController;

#define leftMotor0    4  // Controls the left motor movement
#define leftMotor1   27  // Controls the left motor movement
#define rightMotor0  17  // Controls the right motor movement
#define rightMotor1  25  // Controls the right motor movement
#define swingMotor0  13  // Controls cab swing movement
#define swingMotor1  12  // Controls cab swing movement

#define lightsAttach  5 // Controls headlight control

#define boomMotor0   32 // Controls boom movement
#define boomMotor1   19 // Controls boom movement
#define dipperMotor0 21 // Controls dipper movement
#define dipperMotor1 22 // Controls dipper movement
#define bucketMotor0 33 // Controls bucket movement
#define bucketMotor1 18 // Controls bucket movement

#define clawServoPin 23 // Controls claw servo
#define clawMotor0   16 // Controls claw rotation movement
#define clawMotor1   26 // Controls claw rotation movement

#define deadZone 30
#define clawInitialPosition 45
#define clawMin 30
#define clawMax 115
#define clawSpeed 3         // degrees to move each cycle
#define clawSwivelSpeed 196 // out of 255 - percentage of maximum motor speed
#define throttleMultiplier -0.4f

#define wiggleCountMax 6

Servo clawServo;

int lightSwitchTime = 0;
int clawValue = clawInitialPosition;
bool lightsOn = false;
unsigned long lastWiggleTime = 0;
int wiggleCount = 0;
int wiggleDirection = 1;
long wiggleDelay = 100;
bool shouldWiggle = false;
bool driveMode = true;
bool debounce = false;
const float DEG2RAD = PI / 180.0f;
const float RAD2DEG = 180.0f / PI;

void onConnectedController(ControllerPtr ctl) {
  ControllerProperties properties = ctl->getProperties();
  auto btAddress = properties.btaddr;
  if (myController == nullptr) {
    Serial.printf("CALLBACK: Controller is connected, ADDR=%2X:%2X:%2X:%2X:%2X:%2X\n",
                  btAddress[0], btAddress[1], btAddress[2], btAddress[3], btAddress[4], btAddress[5]);
    // Additionally, you can get certain gamepad properties like:
    // Model, VID, PID, BTAddr, flags, etc.
    Serial.printf("Controller model: %s, VID=0x%04x, PID=0x%04x\n", ctl->getModelName().c_str(), properties.vendor_id,
                  properties.product_id);
    myController = ctl;

    // disable any further BT connections so multiple controllers don't control one vehicle
    BP32.enableNewBluetoothConnections(false);

    ctl->playDualRumble(0 /* delayedStartMs */, 250 /* durationMs */, 0x80 /* weakMagnitude */, 0x40 /* strongMagnitude */);
    shouldWiggle = true;
    processLights(true);
  } else {
    Serial.printf("CALLBACK: Controller connected, ADDR=%2X:%2X:%2X:%2X:%2X:%2X, but another controller already connected.\n",
                  btAddress[0], btAddress[1], btAddress[2], btAddress[3], btAddress[4], btAddress[5]);
    ctl->disconnect();
  }
}

void onDisconnectedController(ControllerPtr ctl) {
  ControllerProperties properties = ctl->getProperties();
  auto btAddress = properties.btaddr;
  if (myController == ctl) {
    Serial.printf("CALLBACK: Controller disconnected ADDR=%2X:%2X:%2X:%2X:%2X:%2X\n",
                  btAddress[0], btAddress[1], btAddress[2], btAddress[3], btAddress[4], btAddress[5]);
    myController = nullptr;
    BP32.enableNewBluetoothConnections(true);
  } else {
    Serial.printf("CALLBACK: Controller disconnected, ADDR=%2X:%2X:%2X:%2X:%2X:%2X, but not active controller\n",
                  btAddress[0], btAddress[1], btAddress[2], btAddress[3], btAddress[4], btAddress[5]);
  }
}

void processGamepad(ControllerPtr ctl) {
  if (isDriveMode(ctl->thumbL())) {
    // move tracks, but stop all movement on arm
    processThrottle(ctl->axisX(), ctl->axisY());
    processSwing(0);
    processBoom(0);
    processDipper(0);
    processBucket(0);
  } else {
    // stop tracks, but allow arm to move
    processThrottle(0, 0);
    processSwing(ctl->axisX());
    processBoom(ctl->axisY());
    processDipper(ctl->axisRY());
    processBucket(ctl->axisRX());
    processClaw(ctl->dpad(), ctl->throttle(), ctl->brake(), ctl->r1(), ctl->l1());
  }
  processLights(ctl->thumbR() | ctl->a());

  processWiggle(ctl->b());
}

void processWiggle(bool value) {
  if (value) {
    shouldWiggle = true;
    processLights(true);
  }
}

void wiggle() {
  unsigned long currentTime = millis();
  if (abs((int)(currentTime - lastWiggleTime)) >= wiggleDelay) {
    lastWiggleTime = currentTime;
    wiggleDirection *= -1;
    wiggleCount++;
    moveMotor(leftMotor0, leftMotor1, wiggleDirection * 100);
    moveMotor(rightMotor0, rightMotor1, wiggleDirection * 100);
    if (wiggleCount >= wiggleCountMax) {
      moveMotor(leftMotor0, leftMotor1, 0);
      moveMotor(rightMotor0, rightMotor1, 0);
      wiggleCount = 0;
      shouldWiggle = false;
      processLights(true);
    }
  }
}

bool isDriveMode(bool buttonValue) {
  if (!debounce && buttonValue) {
    // switch driveMode
    driveMode = !driveMode;
    debounce = true;
    // Serial.printf("Switching driveMode: %s\n", driveMode ? "true" : "false");
  }
  else if (!buttonValue) {
    debounce = false;
  }
  return driveMode;
}

void processThrottle(int newX, int newY) {
  float angle = atan2(newY, newX) * RAD2DEG;
  float amplitude = sqrtf(newX*newX + newY*newY);
  // Serial.printf("angle: %f amplitude: %f ", angle, amplitude);

  float rightMotorValue = ((angle >= 0 && angle <= 90) ? 1 : (angle <= -90 ? -1 : angle > 90 ? cos((180 - angle * 2) * DEG2RAD) : cos(angle * 2 * DEG2RAD))) * amplitude;
  float leftMotorValue = (angle >= 90 ? 1 : (angle <= 0 && angle >= -90) ? -1 : angle > 0 ? cos((180 - angle * 2) * DEG2RAD) : cos(angle * 2 * DEG2RAD)) * amplitude;
  // Serial.printf("left: %f right: %f\n", rightMotorValue, leftMotorValue);

  if (amplitude <= deadZone) {
    rightMotorValue = 0;
    leftMotorValue = 0;
  }

  moveMotor(rightMotor0, rightMotor1, rightMotorValue * throttleMultiplier);
  moveMotor(leftMotor0, leftMotor1, leftMotorValue * throttleMultiplier);
}

void processLeftThrottle(int newValue, bool isReverse) {
  int throttleValue = newValue / 4 * (isReverse ? -1 : 1);
  moveMotor(leftMotor0, leftMotor1, throttleValue);
}

void processRightThrottle(int newValue, bool isReverse) {
  int throttleValue = newValue / 4 * (isReverse ? -1 : 1);
  moveMotor(rightMotor0, rightMotor1, throttleValue);
}

void processSwing(int newValue) {
  int swingValue = newValue / 3;
  if (abs(swingValue) > deadZone) {
    moveMotor(swingMotor0, swingMotor1, swingValue);
  } else {
    moveMotor(swingMotor0, swingMotor1, 0);
  }
}

void processLights(bool buttonValue) {
  if (buttonValue && (millis() - lightSwitchTime) > 200) {
    if (lightsOn) {
      digitalWrite(lightsAttach, LOW);
      lightsOn = false;
    } else {
      digitalWrite(lightsAttach, HIGH);
      lightsOn = true;
    }

    lightSwitchTime = millis();
  }
}

void processBoom(int newValue) {
  int boomValue = newValue / 2;
  if (abs(boomValue) > deadZone) {
    moveMotor(boomMotor0, boomMotor1, boomValue);
  } else {
    moveMotor(boomMotor0, boomMotor1, 0);
  }
}

void processDipper(int newValue) {
  int dipperValue = newValue / 2;
  if (abs(dipperValue) > deadZone) {
    moveMotor(dipperMotor0, dipperMotor1, dipperValue);
  } else {
    moveMotor(dipperMotor0, dipperMotor1, 0);
  }
}

void processBucket(int newValue) {
  int bucketValue = newValue / 2;
  if (abs(bucketValue) > deadZone) {
    moveMotor(bucketMotor0, bucketMotor1, bucketValue);
  } else {
    moveMotor(bucketMotor0, bucketMotor1, 0);
  }
}

void processClaw(int newValue, int swivel_right, int swivel_left, bool claw_close, bool claw_open) {
  if (newValue & DPAD_UP || claw_open) {
    if (clawValue > clawMin) {
      clawValue -= clawSpeed;
      clawServo.write(clawValue);
      // Serial.printf("claw open: %d\n", clawValue);
    }
  }
  else if (newValue & DPAD_DOWN || claw_close) {
    if (clawValue < clawMax) {
      clawValue += clawSpeed;
      clawServo.write((clawValue));
      // Serial.printf("claw close: %d\n", clawValue);
    }
  }
  if (newValue & DPAD_LEFT) {
    moveMotor(clawMotor0, clawMotor1, -1 * clawSwivelSpeed);
  }
  else if (newValue & DPAD_RIGHT) {
    moveMotor(clawMotor0, clawMotor1, clawSwivelSpeed);
  }
  else if (swivel_right > 0 ) {
    moveMotor(clawMotor0, clawMotor1, swivel_right/6);
  }
  else if (swivel_left > 0) {
    moveMotor(clawMotor0, clawMotor1, swivel_left/-6);
  }
  else {
    moveMotor(clawMotor0, clawMotor1, 0);
  }
}

void moveMotor(int motorPin0, int motorPin1, int motorSpeed) {
  if (motorSpeed > 1) {
    analogWrite(motorPin0, motorSpeed);
    analogWrite(motorPin1, LOW);
  } else if (motorSpeed < -1) {
    analogWrite(motorPin0, LOW);
    analogWrite(motorPin1, (-1 * motorSpeed));
  } else {
    analogWrite(motorPin0, 0);
    analogWrite(motorPin1, 0);
  }
}

void processController() {
  if (myController && myController->isConnected() && myController->hasData()) {
    if (myController->isGamepad()) {
      processGamepad(myController);
    } else {
      Serial.println("Unsupported controller");
    }
  }
}

// Arduino setup function. Runs in CPU 1
void setup() {
  pinMode(leftMotor0, OUTPUT);
  pinMode(leftMotor1, OUTPUT);
  pinMode(rightMotor0, OUTPUT);
  pinMode(rightMotor1, OUTPUT);
  pinMode(swingMotor0, OUTPUT);
  pinMode(swingMotor1, OUTPUT);

  pinMode(lightsAttach, OUTPUT);
  digitalWrite(lightsAttach, LOW);

  pinMode(boomMotor0, OUTPUT);
  pinMode(boomMotor1, OUTPUT);
  pinMode(dipperMotor0, OUTPUT);
  pinMode(dipperMotor1, OUTPUT);
  pinMode(bucketMotor0, OUTPUT);
  pinMode(bucketMotor1, OUTPUT);

  pinMode(clawMotor0, OUTPUT);
  pinMode(clawMotor1, OUTPUT);

  clawServo.attach(clawServoPin);
  clawServo.write(clawInitialPosition);
  
  Serial.begin(115200);
  Serial.printf("Firmware: %s\n", BP32.firmwareVersion());
  const uint8_t *addr = BP32.localBdAddress();
  Serial.printf("BD Addr: %2X:%2X:%2X:%2X:%2X:%2X\n", addr[0], addr[1], addr[2], addr[3], addr[4], addr[5]);

  // Setup the Bluepad32 callbacks
  BP32.setup(&onConnectedController, &onDisconnectedController);

  // "forgetBluetoothKeys()" should be called when the user performs
  // a "device factory reset", or similar.
  // Calling "forgetBluetoothKeys" in setup() just as an example.
  // Forgetting Bluetooth keys prevents "paired" gamepads to reconnect.
  // But it might also fix some connection / re-connection issues.
  BP32.forgetBluetoothKeys();

  // Enables mouse / touchpad support for gamepads that support them.
  // When enabled, controllers like DualSense and DualShock4 generate two connected devices:
  // - First one: the gamepad
  // - Second one, which is a "virtual device", is a mouse.
  // By default, it is disabled.
  BP32.enableVirtualDevice(false);
  // You could add additional error handling here,
  // such as logging the error or attempting to recover.
  // For example, you might attempt to reset the MCP23X17
  // and retry initialization before giving up completely.
  // Then, you could gracefully exit the program or continue
  // running with limited functionality.
}



// Arduino loop function. Runs in CPU 1.
void loop() {
  // This call fetches all the controllers' data.
  // Call this function in your main loop.
  bool dataUpdated = BP32.update();
  if (dataUpdated) {
    processController();
  }
  if (shouldWiggle) {
    wiggle();
  }
  // The main loop must have some kind of "yield to lower priority task" event.
  // Otherwise, the watchdog will get triggered.
  // If your main loop doesn't have one, just add a simple `vTaskDelay(1)`.
  // Detailed info here:
  // https://stackoverflow.com/questions/66278271/task-watchdog-got-triggered-the-tasks-did-not-reset-the-watchdog-in-time

  //     vTaskDelay(1);
  else { vTaskDelay(1); }
}
