swholmstead/Excavator/(commit log)

2025-02-03 Added ESP32 pins for various excavator motors
2025-02-04 Added schematic and PCB files
2025-02-06 Updated code to have pins of prototype
2025-02-06 Split left and right throttle
2025-02-06 Fixed left throttle
2025-02-07 Changed to no used reserved ESP32 pins
2025-02-08 Functioning left, right, swing motors
2025-02-08 Updated to final motor pins
2025-02-08 Added control for boom, bucket, and dipper
2025-02-08 changed velocity to motorSpeed
2025-02-10 Added claw and swivel dpad control
2025-02-10 Adjusted pin assignments
2025-02-11 Reworked pins to non PWM GPIO for dipper motor
    [Excavator_Bluepad.ino]
2025-02-11 Pin assignments for V2 hardware
2025-02-20 Wrote code for claw
2025-02-22 Fixed claw to operate correctly.
    [Excavator_Bluepad.ino]
2025-02-24 Updated PCB
2025-09-10 Change controller operations
    Added "drive mode". Clicking left joystick button toggles drive mode.
    Can move arm only when NOT in drive mode.
2025-09-17 Fixed readme and schematics
2025-09-17 Updated bom
2025-09-18 Began assembly instructions
2025-09-18 Lower support assembly
2025-09-18 Added more assembly instructions
2025-09-18 More assembly instructions
2025-09-18 fixes to assembly
2025-09-19 added more controls for claw open/close
2025-09-19 Added claw picture
2025-09-20 Claw instructions
2025-09-20 Updated assembly instructions
2025-09-20 assembly instructions
2025-09-20 Bucket assembly
2025-09-20 Finished claw assembly
2025-09-21 Adjust claw starting position
2025-09-21 Switched pins for swing and claw
2025-09-23 Finished assembly instructions
2025-09-23 reversed claw open/close on controller
    [Excavator_Bluepad.ino]
2025-09-28 Fixed boom, bucket motor directions
    [Excavator_Bluepad.ino]
2025-11-24 Update assembly.md
    Improving directions to specify motor instead of battery.
